IowaScaledEngineering/mrbw-cst/mech/pcb/front/img/faceplate-cu-1943.png

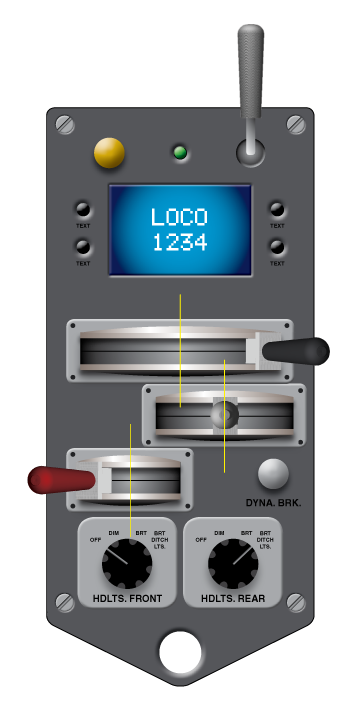
mech/pcb/front/img/faceplate-cu-1943.png
