IowaScaledEngineering/mrbw-cst/mech/pcb/front/img/lcd.jpg

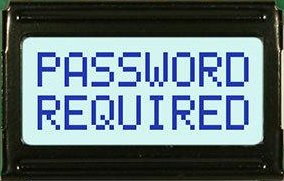
mech/pcb/front/img/lcd.jpg
