IowaScaledEngineering/mrbw-cst/mech/pcb/front/img/faceplate-1591d.png

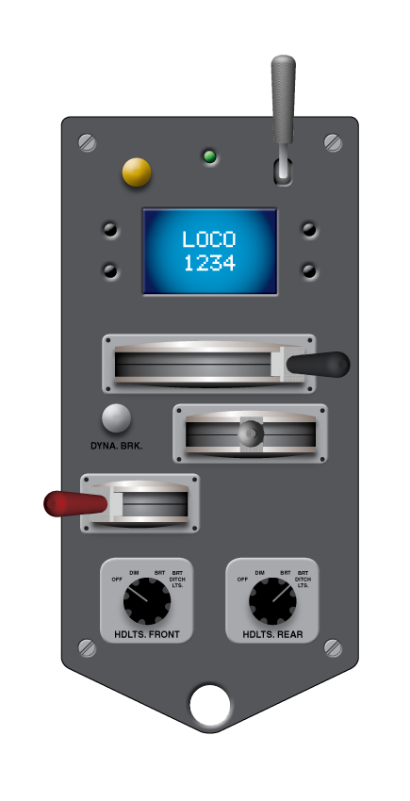
mech/pcb/front/img/faceplate-1591d.png
