IowaScaledEngineering/mrbw-cst/doc/calculations.ods

R1 | 0 | k
R2 | 200 | k
R3 | 100 | k
R4 | 49.9 | k
R5 | 0 | k to GND
VDD | 3.3 | V
 |  |  | Ideal
RA (R1/R2) | 3.300 | V | 3.3 | V
RB (R3/R2) | 2.200 | V | 2.2 | V
RC (R3/R4) | 1.099 | V | 1.1 | V
RD (R5/R4) | 0.000 | V | 0 | V
R1 | 10 | k
R2 | 69.8 | k
R3 | 42.2 | k
R4 | 25.5 | k
R5 | 178 | k
VDD | 3.3 | V
 |  |  | Ideal
RA (R1/R2) | 2.886 | V | 2.8875 | V
RB (R3/R2) | 2.057 | V | 2.0625 | V
RC (R3/R4) | 1.243 | V | 1.2375 | V
RD (R5/R4) | 0.414 | V | 0.4125 | V
