IowaScaledEngineering/mrbw-cst/doc/datasheets/NHD-0208AZ.STEP

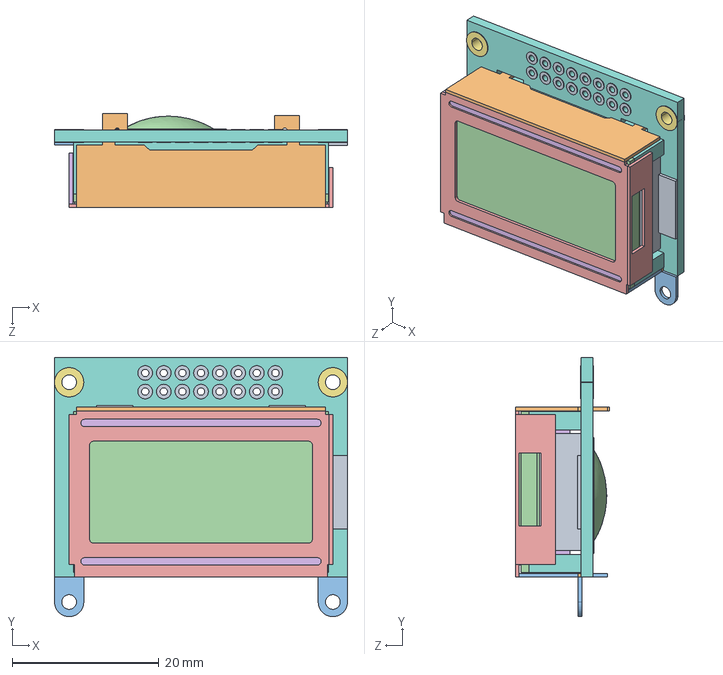
[picture p4: CAD file, 2018-02-15]
doc/datasheets/NHD-0208AZ.STEP
40.0 x 35.4 x 12.9 mm
