IowaScaledEngineering/mrbw-cst/mech/encoder-bracket/encoder-bracket-thread.stl

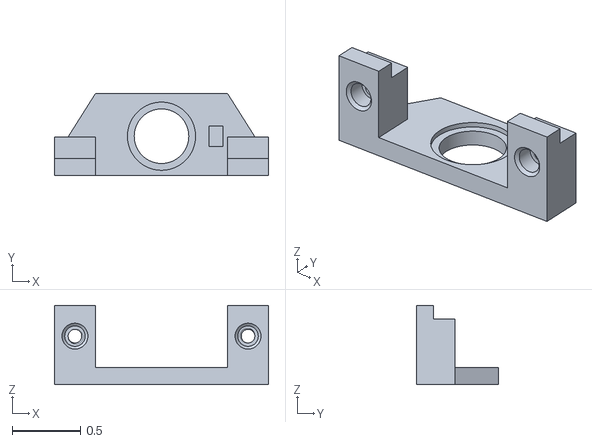
[picture p5: CAD file, 2020-06-07]
mech/encoder-bracket/encoder-bracket-thread.stl
1.57 x 0.6 x 0.58
