IowaScaledEngineering/mrbw-cst/mech/knob-holder/knob-holder v8.stl

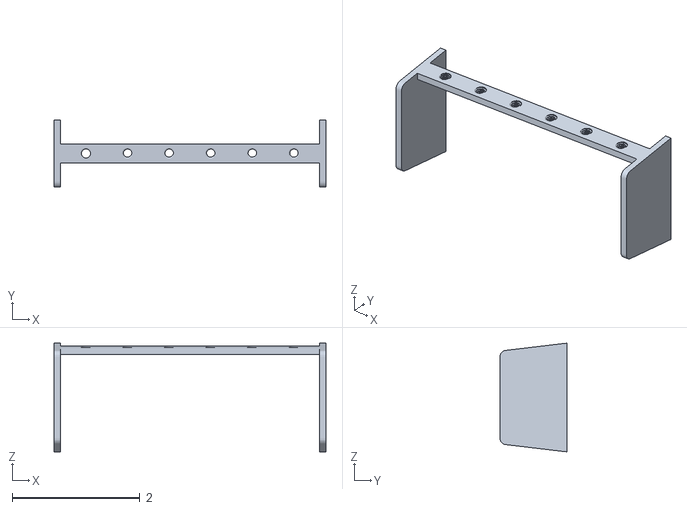
[picture p6: CAD file, 2024-02-22]
mech/knob-holder/knob-holder v8.stl
4.25 x 1.05 x 1.70
