IowaScaledEngineering/mrbw-cst/mech/pt-pocket/pt-pocket.stl

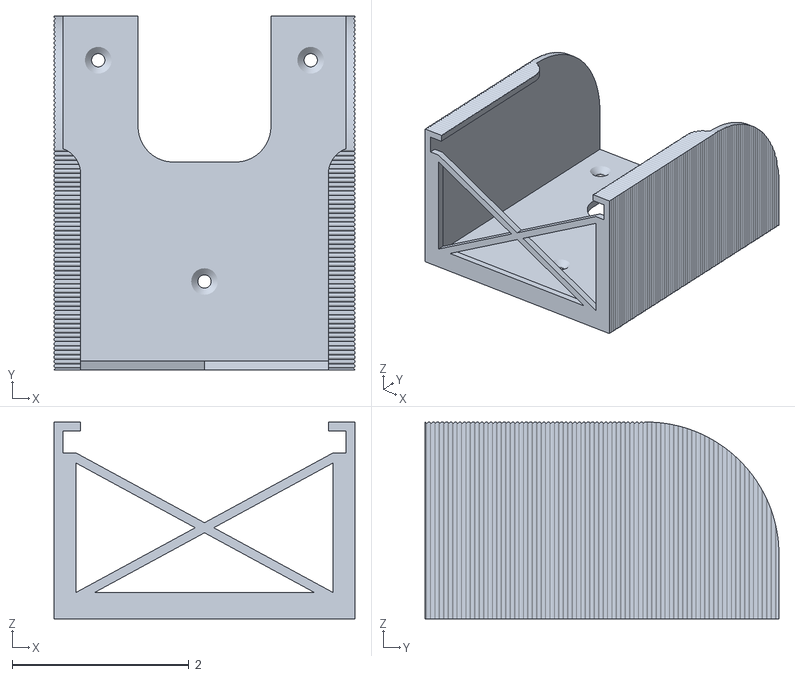
[picture p7: CAD file, 2019-04-13]
mech/pt-pocket/pt-pocket.stl
3.40 x 4.00 x 2.23
