IowaScaledEngineering/mrbw-cst/mech/window/window.dxf

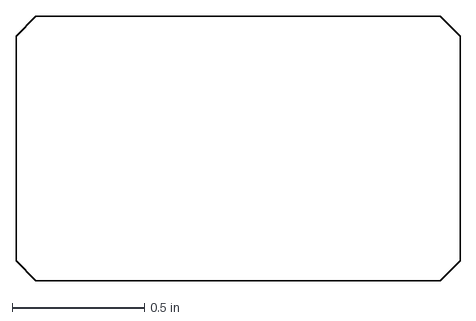
[picture p8: CAD file, 2020-03-28]
mech/window/window.dxf
1.68 x 1.00 in
