IowaScaledEngineering/mrbw-cst/mech/encoder-bracket/encoder-bracket.stl

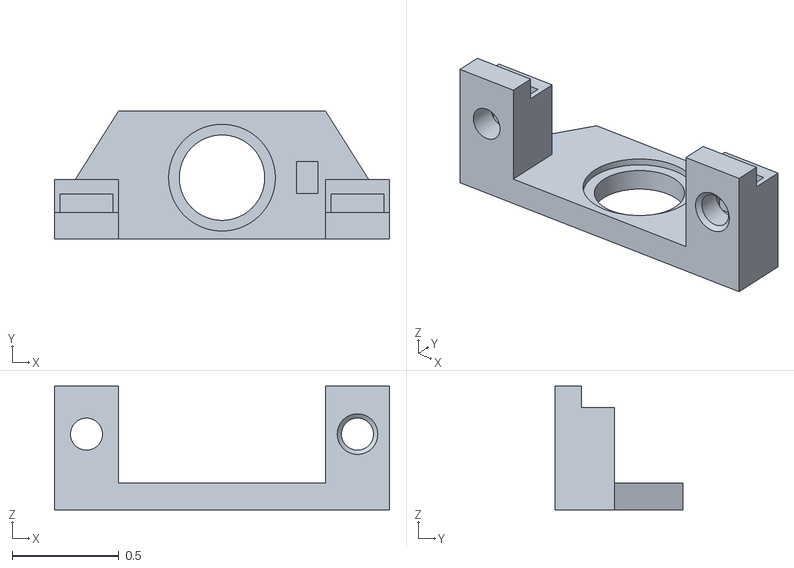
[picture p9: CAD file, 2019-06-08]
mech/encoder-bracket/encoder-bracket.stl
1.57 x 0.6 x 0.58
