IowaScaledEngineering/mrbw-cst/(list of files, cad)

Other CAD files:
mech/pcb/front/front.dwg
mech/pcb/front/parts/mrbw-cst.dwg
mech/pcb/side/side.dwg
mech/pcb/front/parts/PVA1.dwg
mech/pcb/side/parts/PPTC032LJBN-RC.dwg
mech/pcb/front/parts/mrbw-cst-lcd.dwg
mech/pcb/side/parts/2-1825910-(6-9).dwg
mech/pcb/front/parts/PTV09A-2020F-B104.dwg
mech/pcb/side/parts/3-1825910-(1-3).dwg
mech/pcb/front/parts/PPTC032LJBN-RC.dwg
mech/pcb/side/parts/NHD-0208AZ-FSW-GBW-33V3.dwg
mech/pcb/front/parts/CU-1943.dwg
mech/pcb/side/parts/PVA1-OA-H4.dwg
mech/pcb/front/parts/Hammond-1591D.dwg
mech/pcb/side/parts/PVA1-EE-H2.dwg
mech/pcb/front/parts/Rxxx07RN02Q.dwg
mech/pcb/side/parts/PVA1-OA-H2.dwg
mech/pcb/front/parts/25LB10-Q.dwg
mech/pcb/side/parts/Rxxx07RN02Q.dwg
mech/pcb/side/parts/PVA1-OA-H3.dwg
mech/pcb/side/parts/25LB10-Q(side).dwg
mech/pcb/side/parts/100SP2T1B1M1QEH.dwg
mech/pcb/side/parts/PTV09A-2020F-B104.dwg
mech/encoder-bracket/encoder-bracket-thread.f3d
mech/encoder-bracket/encoder-bracket.dwg
mech/encoder-bracket/encoder-bracket.f3d
mech/pcb/side/parts/6094K850_INDICATING_KNOB.DWG
