IowaScaledEngineering/mrbw-cst/pg/lcd-test-v1.0-a69d3a3/lcd-test-pcb.pdf

# lcd-test.pcb

# 1. Table of Contents (This Page) Created on Thu Jul 2 14:53:42 2020

# 2. top 3. bottom 4. outline 5. plated-drill 6. componentmask 7. soldermask 8. topsilk 9. bottomsilk 10. toppaste 11. topassembly 12. bottomassembly 13. fab

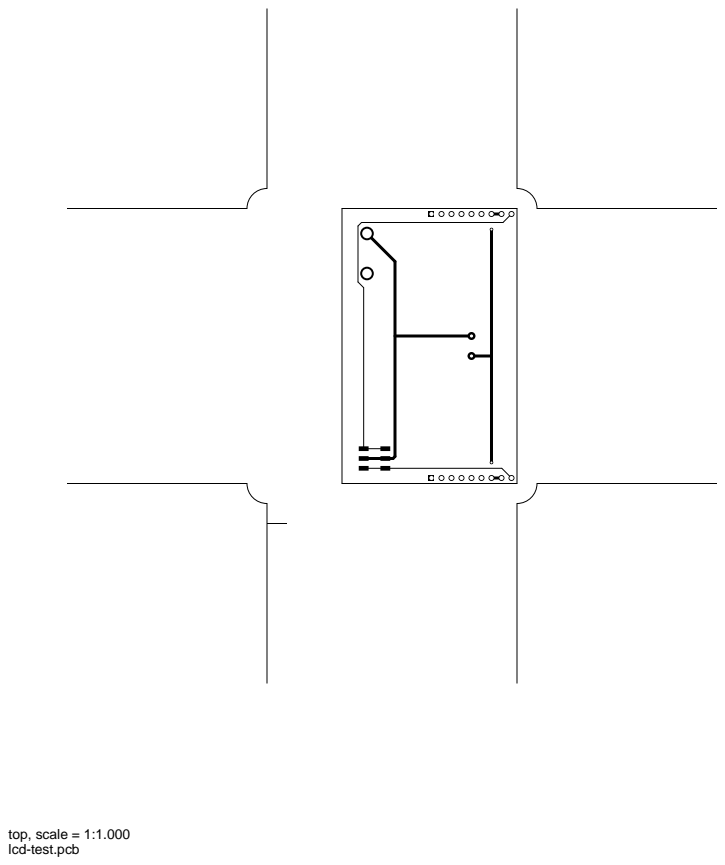
[picture p75: page 2]
top, scale = 1:1.000

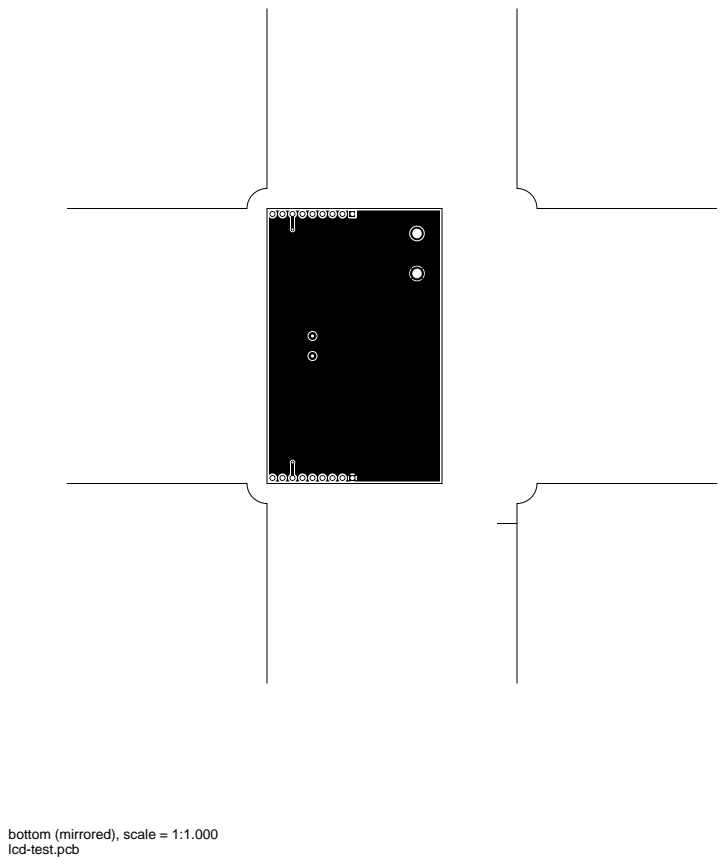
[picture p76: page 3]

bottom (mirrored), scale = 1:1.000

outline, scale = 1:1.000 plated-drill, scale = 1:1.000

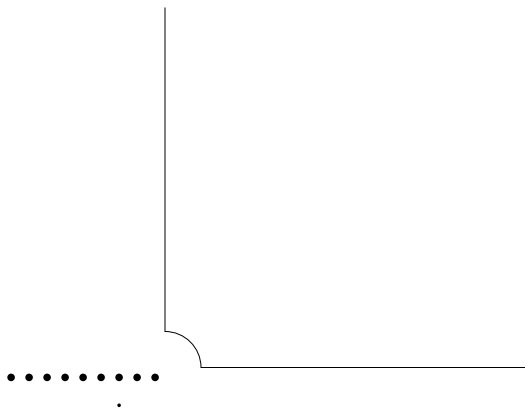
[picture p77: figure]
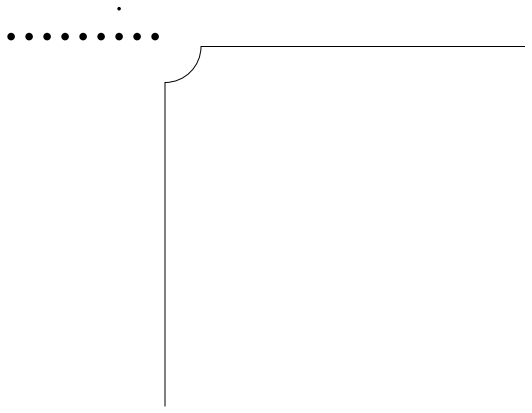
[picture p78: figure]

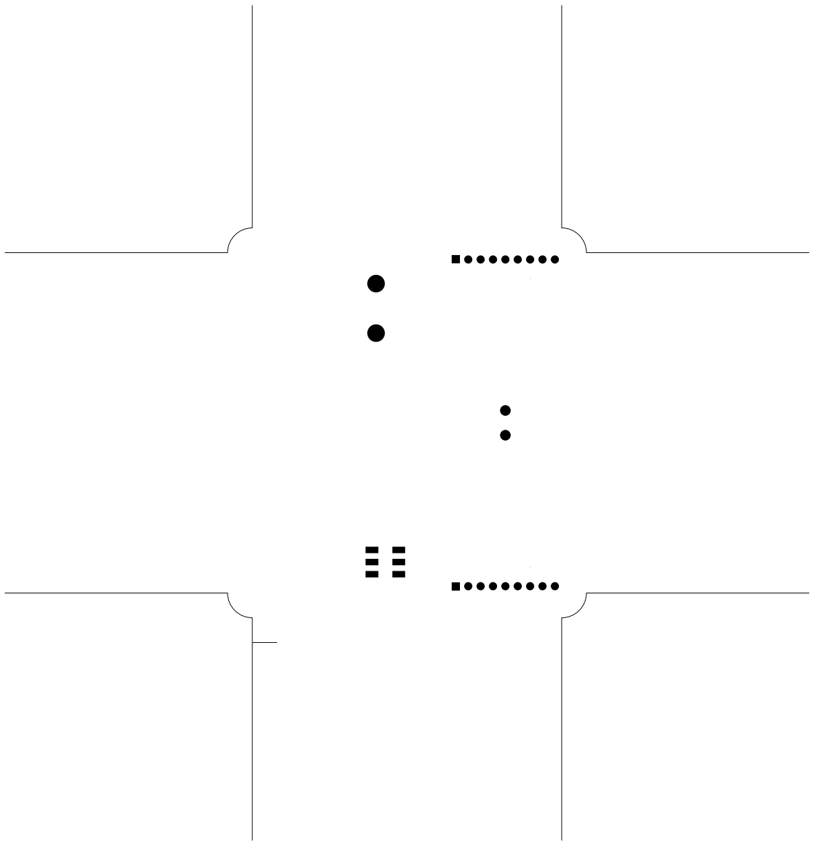
[picture p79: figure]

topmask, scale = 1:1.000

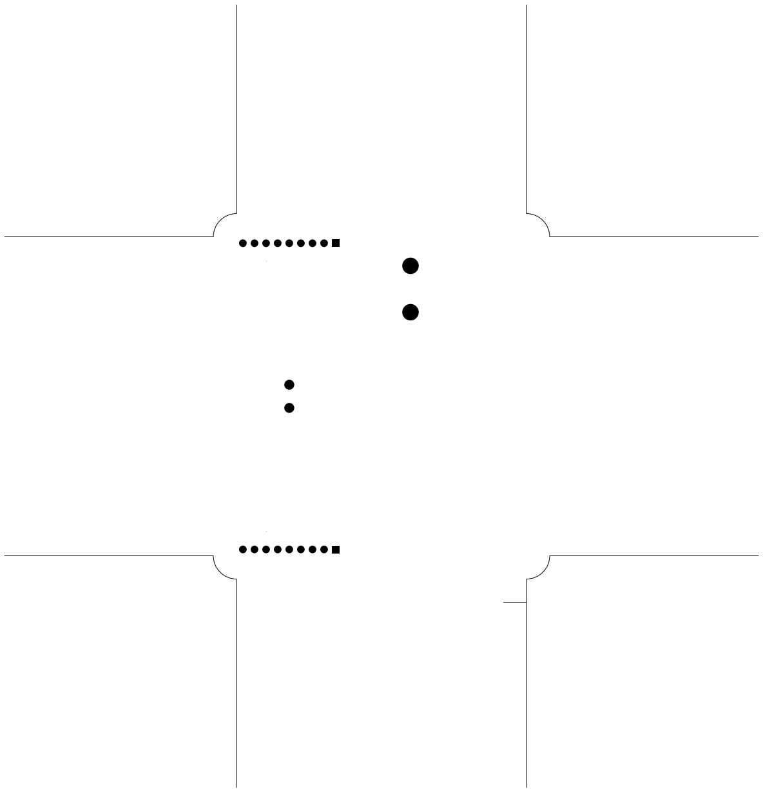
[picture p80: figure]

bottommask (mirrored), scale = 1:1.000

topsilk, scale = 1:1.000

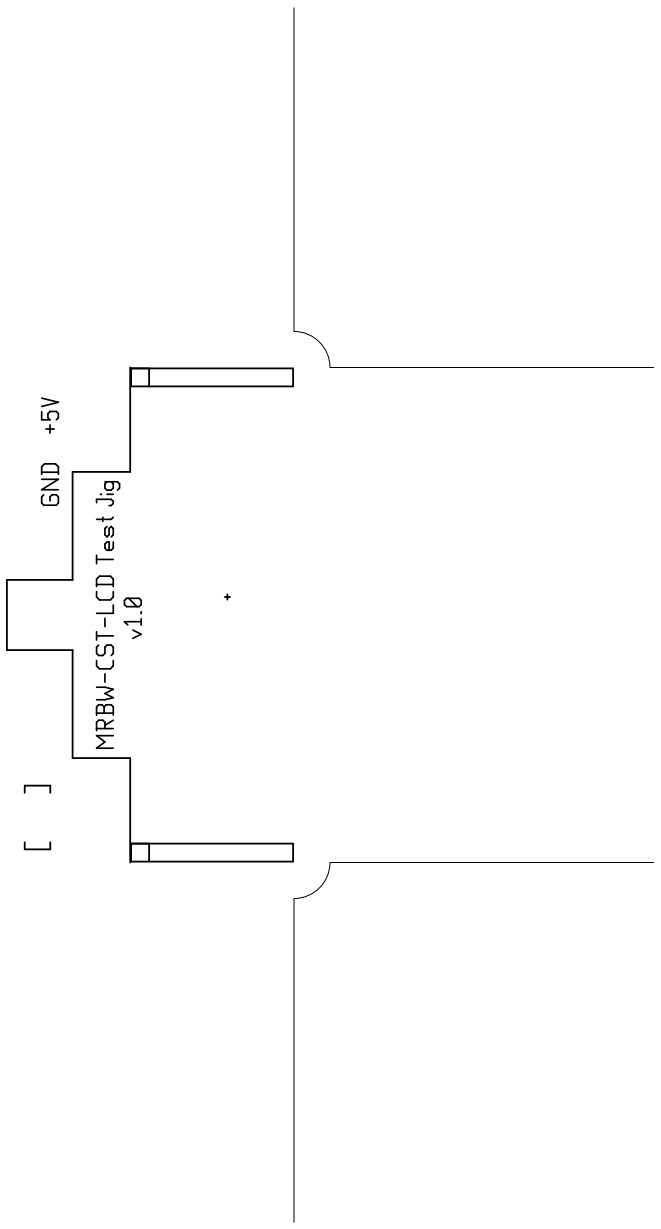
[picture p81: figure]

bottomsilk (mirrored), scale = 1:1.000

toppaste, scale = 1:1.000

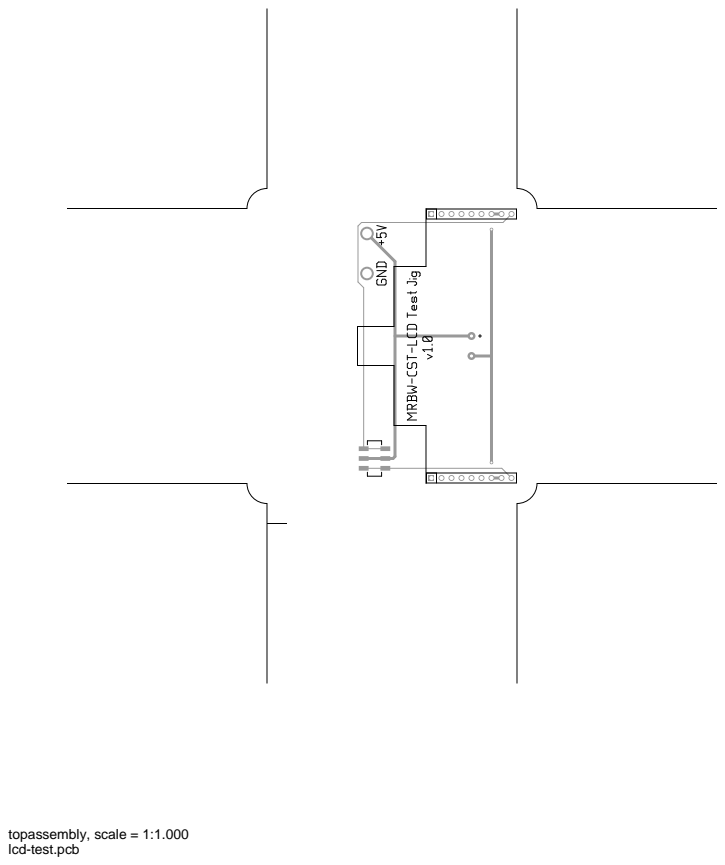
[picture p82: page 11]
topassembly, scale = 1:1.000

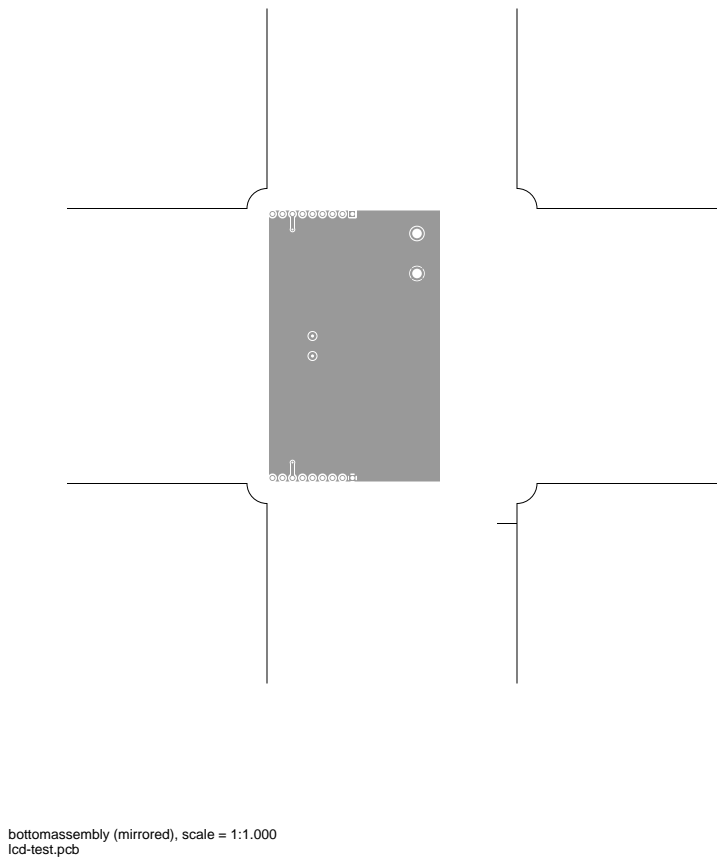
[picture p83: page 12]

bottomassembly (mirrored), scale = 1:1.000

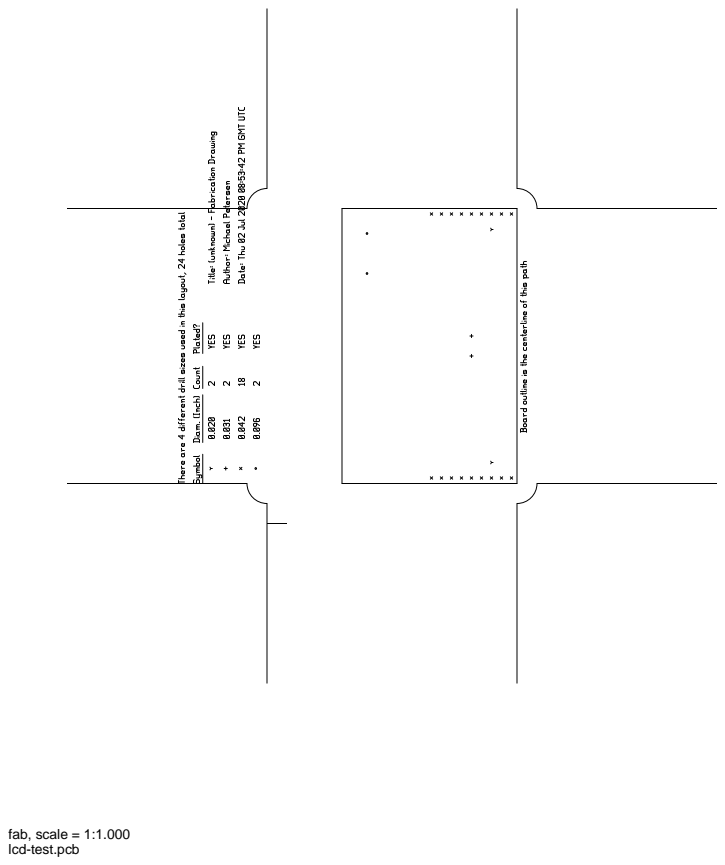
[picture p84: page 13]
fab, scale = 1:1.000
