IowaScaledEngineering/mrbw-cst/(threads)

Thread 1 (2016-07-19):

Missing pin 1 mark on MP1

petersenm, 2016-07-19:

petersenm, 2016-09-14:
Fix in 935ed32

Closed 2016-09-14.

Thread 3 (2016-07-19):

Use unused r-pack resistor for R3?

petersenm, 2016-07-19:

petersenm, 2016-09-14:
Not fixing.  No convenient path to R7 or R10.

Closed 2016-09-14.

Thread 4 (2016-07-19):

Use unused r-pack resistor for R5?

petersenm, 2016-07-19:
Also change C7 to 0.1uF.

petersenm, 2016-09-14:
Not changing.  There are no 10k r-packs and 100k is not typically used for /DTR based reset, which is planned for the future for Arduino compatibility.

Closed 2016-09-14.

Thread 6 (2016-10-09):

Reverse light switch connections so it defaults to "off" when breaking-before-making

petersenm, 2016-10-09:

petersenm, 2016-10-13:
Current operation, after refactoring the ADC code, seems to behave better.  Not sure why...

petersenm, 2017-01-16:
No design change.

Closed 2017-01-16.

Thread 7 (2016-10-10):

Connect backlight drive to PWM output pin to allow adjustment

petersenm, 2016-10-10:

petersenm, 2016-10-11:
Not changing.  Defaulted the screen to off in the main screen and provided an option to toggle the backlight on/off.

Closed 2016-10-11.

Thread 8 (2016-10-11):

Swap front and rear light switches

petersenm, 2016-10-11:
Front should be on the right.

Closed 2017-01-15.

Thread 11 (2016-11-10):

Add charging port

petersenm, 2016-11-10:

petersenm, 2017-03-23:
Added in v1.1 but won't be populated.

Closed 2017-03-23.

Thread 12 (2016-11-10):

Add USB port

petersenm, 2016-11-10:

petersenm, 2017-01-18:
No change.  Decided to leave the 6-pin ISP header as the programming port.  Fitting the UART and USB jack would be difficult and not provide much additional benefit.

Closed 2017-01-18.

Thread 16 (2017-03-25):

Move horn potentiometer right to eliminate collision with LCD board

petersenm, 2017-03-25:

Closed 2017-07-23.

Thread 17 (2017-03-25):

Replace light selection rotary switches

petersenm, 2017-03-25:

petersenm, 2017-04-05:
Original switches have a large region of "break" before making the next contact.  This allows the sensed voltage to swing low or high, both of which are also valid states.  The connection can be broken just by slightly applying pressure to the knob.  Since the throttle requires both poles to generate the switch position voltage, a single pole disconnecting is problematic.

E-Switch KC14A10.001NPS looks very promising as a substitute.  This would also allow a single voltage divider to set the tap points with both switches selecting from that divider (simplified design).

Closed 2017-07-20.

Thread 25 (2017-06-28):

Move E-stop to a different control

petersenm, 2017-06-28:

petersenm, 2017-08-15:
Decided with Scott to allow the user the choice of putting E-stop on the brake handle (as it currently stands), on one of the pushbuttons, or leave it off entirely.  Fully configurable.

petersenm, 2017-09-22:
Changed decision.  Just added option to have e-stop on brake handle or not.  No moving it to other controls.  Fixed by b3dcac883783b317102caad887ab386dba354539 .

Closed 2017-09-22.

Thread 26 (2017-06-28):

Add feedback when the electronic interlock between the throttle and reverser is active

petersenm, 2017-06-28:

petersenm, 2017-09-22:
Fixed by commit cd0187b.

Closed 2017-09-22.

Thread 28 (2017-09-28):

Packet timeout counter should have a power-on reset value of 0

petersenm, 2017-09-28:
Green LED blinks momentarily on a power-on-reset.

Closed 2017-09-30.

Thread 29 (2017-09-28):

Menu button doesn't work after a factory reset

petersenm, 2017-09-28:

Closed 2017-09-30.

Thread 30 (2017-11-22):

Add optional brake off function

petersenm, 2017-11-22:
This function is sent when the brake handle is moved to the left position.

petersenm, 2018-02-10:
Fixed by e469eb57a0213f46b7f42979ef8ab9b42b324d93

Closed 2018-02-10.

Thread 38 (2018-01-07):

Add preference option to remove the interlock between reverser and throttle

petersenm, 2018-01-07:

Thread 49 (2018-04-13):

In variable braking mode, the Brake Off function should be activated opposite the Brake function

petersenm, 2018-04-13:

petersenm, 2018-04-22:
Fixed in cef6c46

Closed 2018-04-22.

Thread 53 (2018-04-20):

Manual updates

petersenm, 2018-04-20:
New load/save configuration menus
Number of configs = 20
Function for rev swap
Brake type option
Moved some global preferences to per-config options
Update page 5 list of supported systems

Closed 2018-06-15.

Thread 54 (2018-04-21):

Move variable brake to a per-configuration option setting

petersenm, 2018-04-21:

petersenm, 2018-05-12:
Fixed in fb8f584

Closed 2018-05-12.

Thread 55 (2018-04-21):

Add pulsed (PWM) vs. stepped braking option

petersenm, 2018-04-21:
Pulse is universal.  Stepped is targeted at TCS.

petersenm, 2018-05-12:
Fixed in 0866e74

Closed 2018-05-12.

Thread 60 (2018-07-11):

Make menu button long-press escape any menu, including sub-menus

petersenm, 2018-07-11:

petersenm, 2020-03-28:
Not a great idea.  Can escape some menus with changes still intact.  Forcing a SELECT button exit reinforces that changes were saved.

Closed 2020-03-29.

Thread 61 (2018-07-14):

Add a null address so the throttle can be put in a state where it doesn't send updates

petersenm, 2018-07-14:
...or conflict with another locomotive address being used by a different throttle.

Thread 62 (2018-07-14):

Add menu lock

petersenm, 2018-07-14:
Options:
1)  Prompted button press sequence
2)  Unprompted ("secret") button press sequence
3)  PIN #
4)  Full reboot (remove/reinsert batteries)

petersenm, 2018-07-14:
One response from the PT list:
"something to keep an operator from changing throttle settings, not something to prevent unauthorized entry"

petersenm, 2018-10-03:
Fixed in a08c1f4

Closed 2018-10-03.

Thread 63 (2018-07-23):

Fix low battery behavior

petersenm, 2018-07-23:
The throttle enters a hiccup mode when the battery gets critically low.  Possible solution is to go into a low power state when the battery voltage is low.

petersenm, 2018-07-23:
If possible, send an estop command when battery is low.

petersenm, 2018-07-25:
Or put the throttle in idle, engage the brake function, and sound the horn (suggestion from PT list)

petersenm, 2018-09-22:
Just put the throttle in a low power state.  Sending XBee packets is what causes the hiccup mode in the first place.  Stopping the train will be taken care of on the receiver side.

Closed 2018-09-22.

Thread 64 (2018-08-01):

Save current engine on/off state with each configuration

petersenm, 2018-08-01:

petersenm, 2018-08-01:
https://groups.io/g/ProtoThrottle/message/779

petersenm, 2018-09-22:
Should this track configurations?  The problem with that is the locomotive address of a config can be changed temporarily to address a different locomotive.  In that case, it should really track locomotive address.  But that has unrealistic memory requirements to track ALL possible addresses.  Perhaps just a FIFO of the last N addresses used?

Thread 65 (2018-08-12):

Add programmable battery low thresholds

petersenm, 2018-08-12:
This can be used to accommodate NiMH vs. Alkaline battery discharge curves.

petersenm, 2018-10-11:
Fixed in 179ac77

Closed 2018-10-11.

Thread 73 (2018-09-28):

Add indicator for AUX button on main screen

petersenm, 2018-09-28:

petersenm, 2018-10-03:
Resolved in 268238b

Closed 2018-10-03.

Thread 75 (2018-10-11):

Rework maxDeadReckoning preference so limiting (and default) is done in cst-time

petersenm, 2018-10-11:
See battery levels in SYSTEM menu, and resetConfig, for examples.

Closed 2020-03-28.

Thread 78 (2018-11-08):

Provide option to replace fast clock display with other information

petersenm, 2018-11-08:
https://groups.io/g/ProtoThrottle/message/1284

petersenm, 2020-03-29:
Idea #1: Brake percentage

petersenm, 2020-03-29:
Ideas:

petersenm, 2020-03-29:
Ideas:
1) Brake percentage
2) Speed (or some representation of it)

petersenm, 2022-02-20:
3. Notch #

Thread 79 (2019-01-24):

Select button on ENGINE menu activates power down mode

petersenm, 2019-01-24:
Although not intended, this might be a feature?  Best to understand why it happens, though.

petersenm, 2019-01-24:
Same for tonnage menu

Closed 2019-02-12.

Thread 81 (2019-11-13):

Add alerter function

petersenm, 2019-11-13:
From a customer request:
"I'm thinking of having it ring the bell (which will be on F1) after about 90 seconds of no throttle inputs. If still no input after another 30 seconds, then it should set throttle to idle and apply brakes. Times should be adjustable, of course. This will be used with Loksound V5 decoders, and brake will probably be on F6, but the function should be assignable. If for some reason it's too hard to have the throttle go to idle, overriding the throttle handle, then I'll be sure that "Drive Stop" is turned on in the decoder programming for the Independent Brake sound slot. That will also cause the loco to come to a stop."  (#6109)

petersenm, 2020-04-04:
Done in ab6d867

Closed 2020-04-04.

Thread 82 (2019-11-17):

Add button option to jump into special funcs menu.

petersenm, 2019-11-17:

petersenm, 2020-04-01:
Fixed in 8a039a0

Closed 2020-04-01.

Thread 87 (2020-05-10):

Add brake pipe pressure options

petersenm, 2020-05-10:
70PSI (very early, 20PSI reduction)
80PSI (1940's - 1970's, 23PSI reduction)
90PSI (1970's on, 26PSI reduction)
110PSI (Passenger, 32PSI reduction)

petersenm, 2020-05-10:
Also, brake lever position should correspond to a specific pipe reduction from maximum (not from current pressure).

Thread 89 (2020-09-25):

Use aux button to swap throttle lever from throttle function to dynamic brake function

petersenm, 2020-09-25:

Thread 94 (2021-04-18):

Unprogrammed throttle resets to the wrong DIAG screen

petersenm, 2021-04-18:
Subscreen number is off by one.

Thread 97 (2021-11-07):

Don't toggle backlight off when pressing select button until button is released

petersenm, 2021-11-07:
This will leave backlight on while long pressing for shutdown.  Backlight should remain on during long press regardless of initial backlight state.

(From email to support@iascaled.com 2021-05-23 13:07, RE: Broken Throttle Lever)
