IowaScaledEngineering/mrbw-cst/pg/mrbw-cst-v1.2-ddb21f6/mrbw-cst.pdf

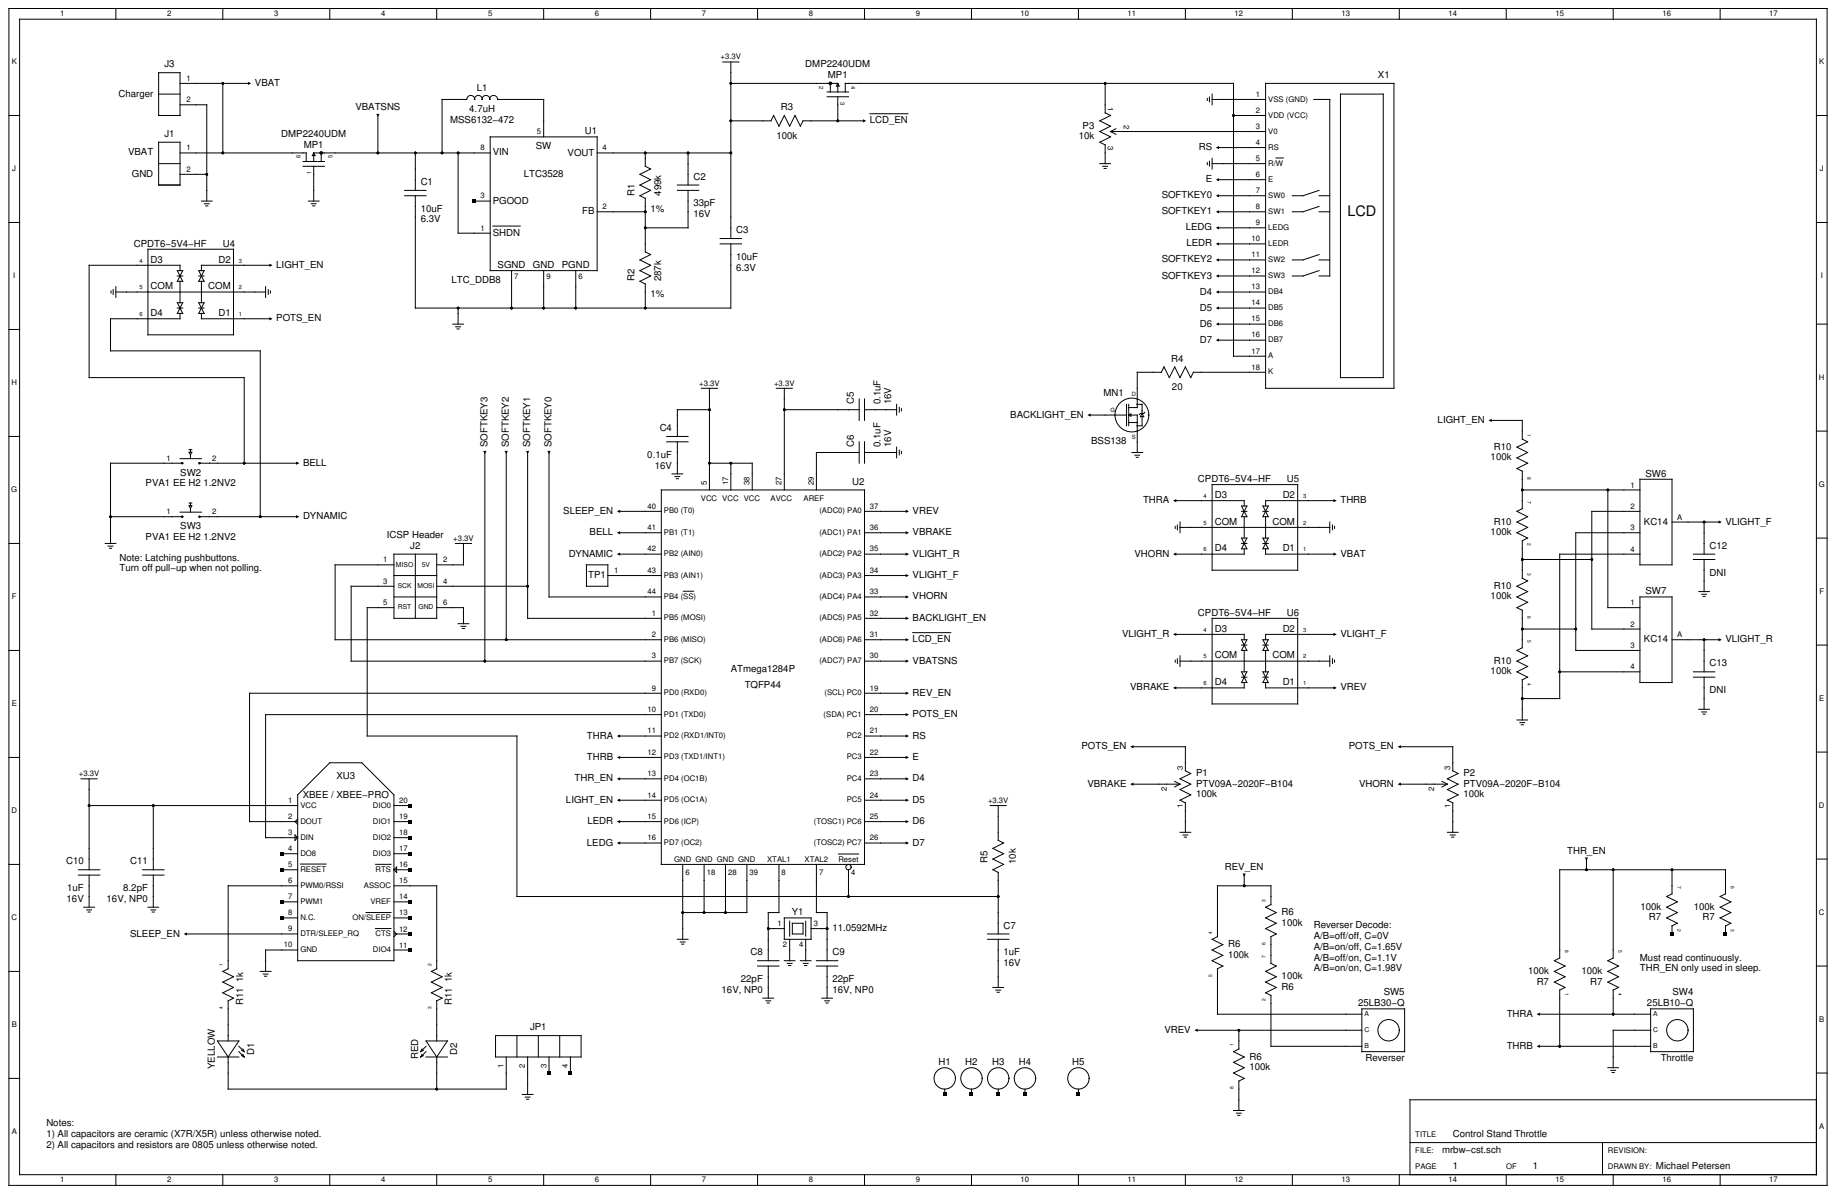
[picture p85: page 1]

Note: Latching pushbuttons.
Turn off pull−up when not polling.

Must read continuously.
THR_EN only used in sleep.

Notes:
1) All capacitors are ceramic (X7R/X5R) unless otherwise noted.
2) All capacitors and resistors are 0805 unless otherwise noted.
