IowaScaledEngineering/mrbw-cst/pg/mrbw-cst-v1.2-ddb21f6/mrbw-cst-pcb.pdf

# mrbw-cst.pcb

# 1. Table of Contents (This Page) Created on Mon Aug 21 20:05:26 2017

# 2. top 3. bottom 4. outline 5. plated-drill 6. componentmask 7. soldermask 8. topsilk 9. bottomsilk 10. toppaste 11. topassembly 12. bottomassembly 13. fab

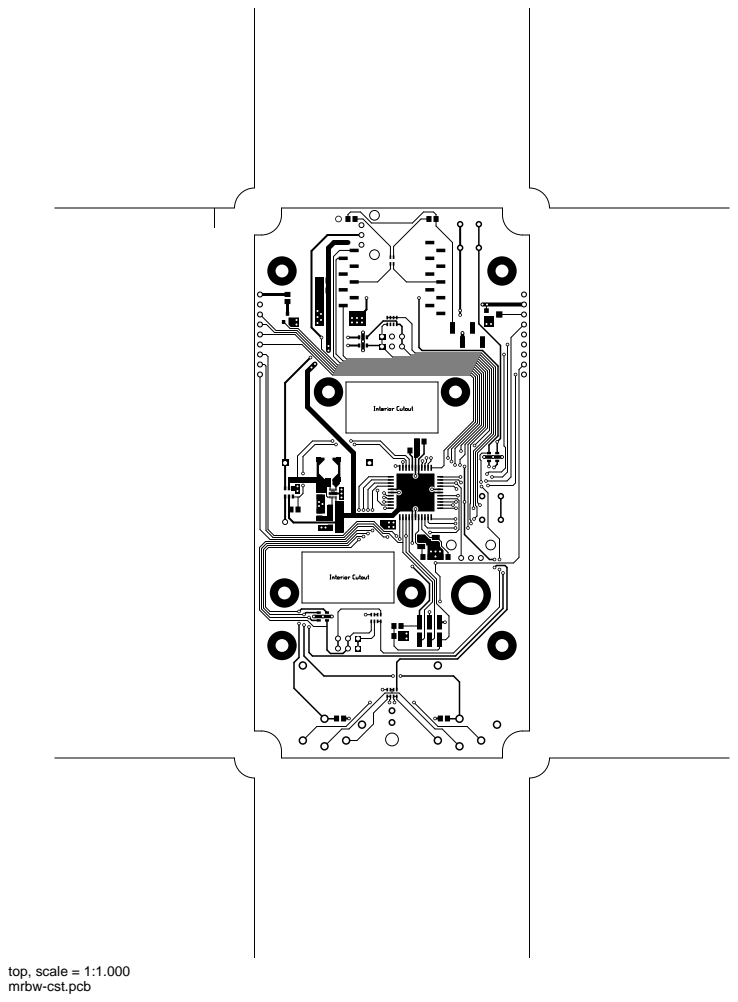
[picture p86: page 2]
top, scale = 1:1.000

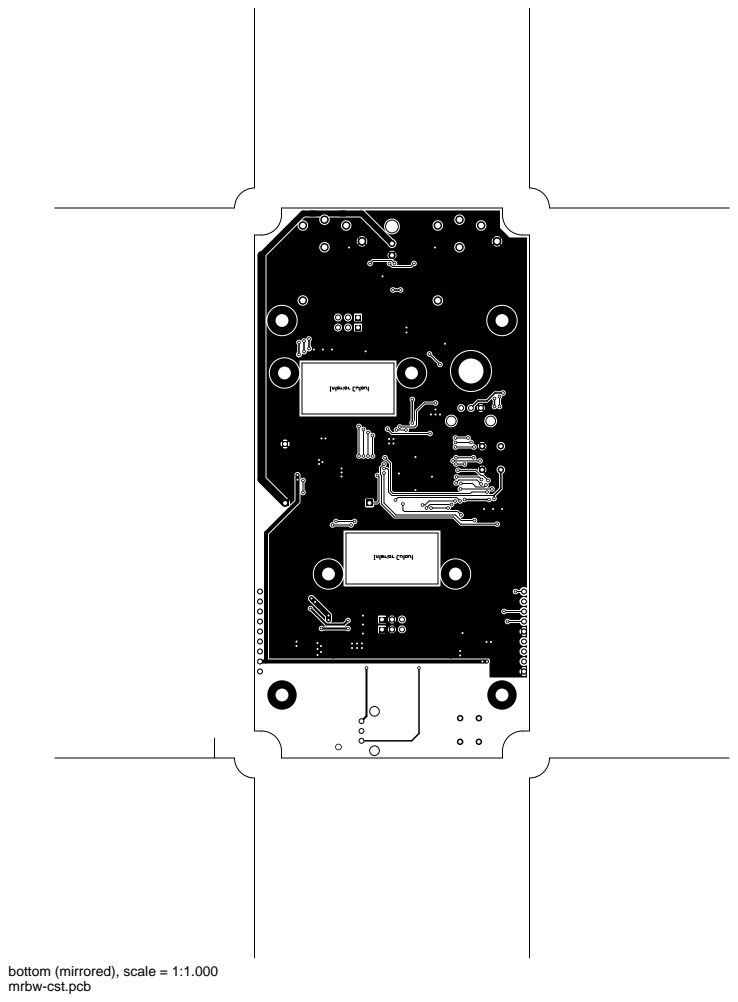
[picture p87: page 3]

bottom (mirrored), scale = 1:1.000

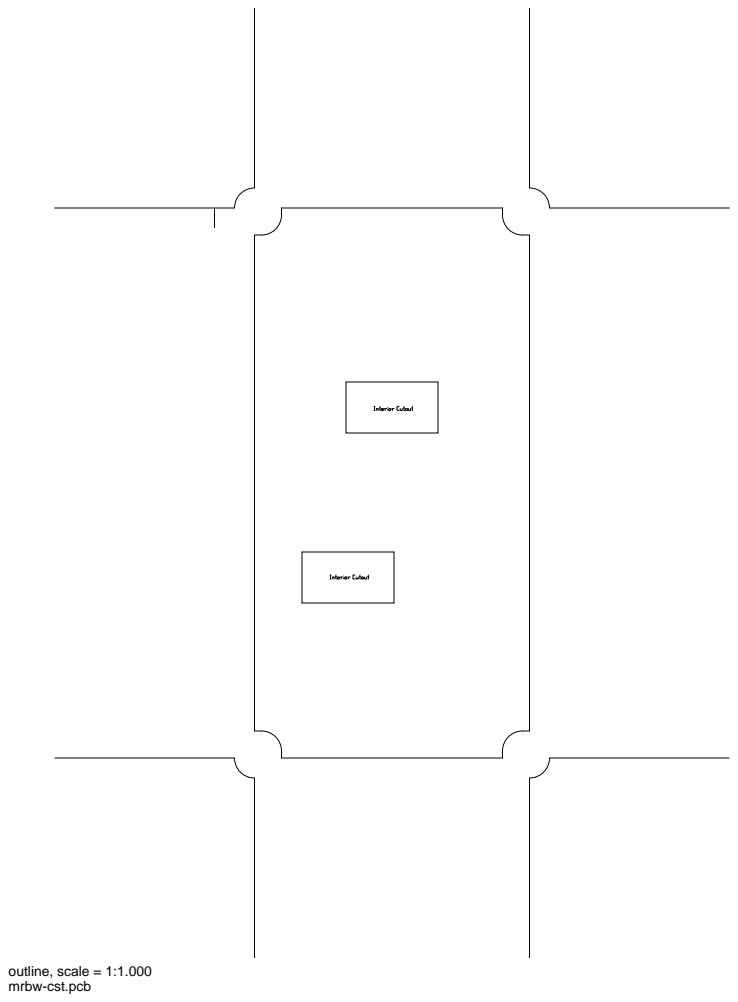
[picture p88: page 4]
outline, scale = 1:1.000

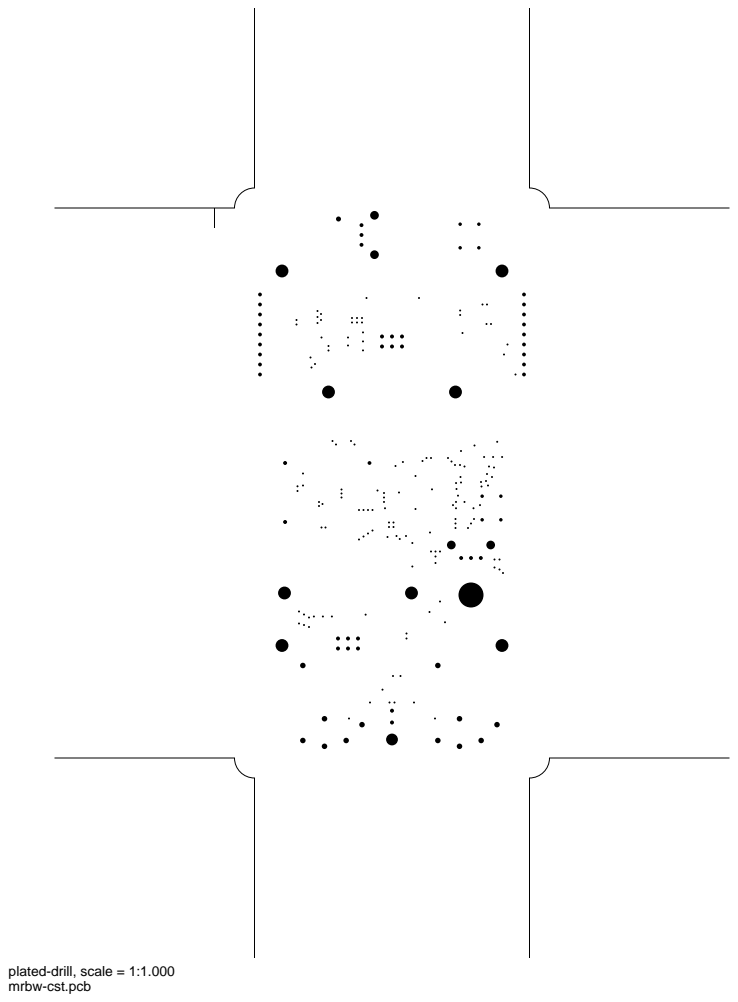
[picture p89: page 5]

plated-drill, scale = 1:1.000

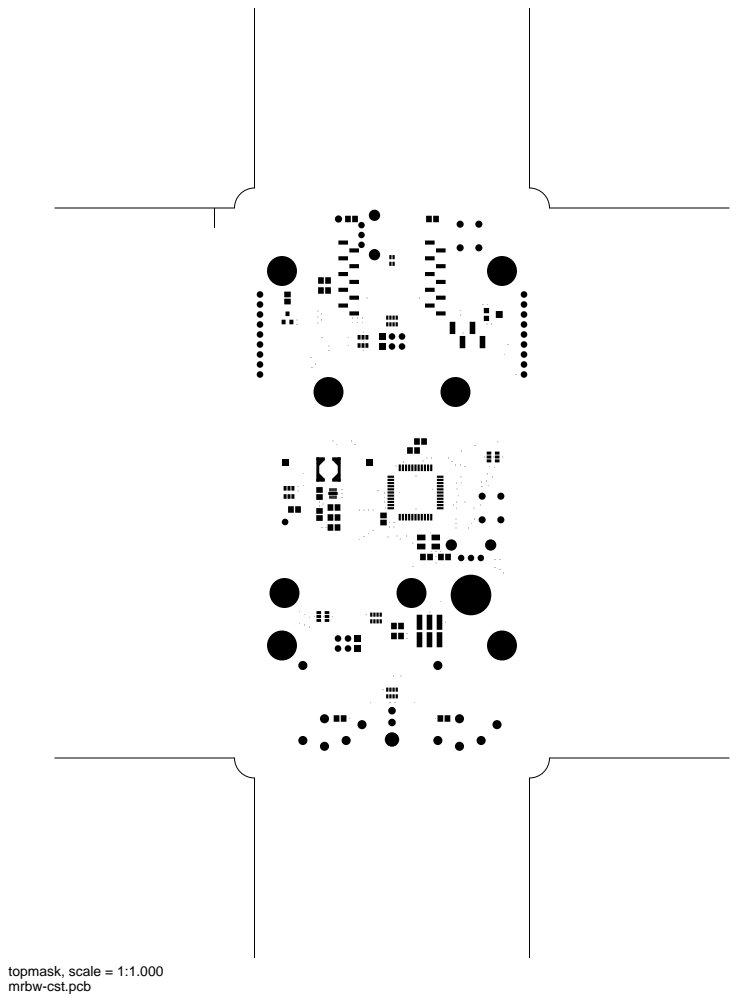
[picture p90: page 6]
topmask, scale = 1:1.000

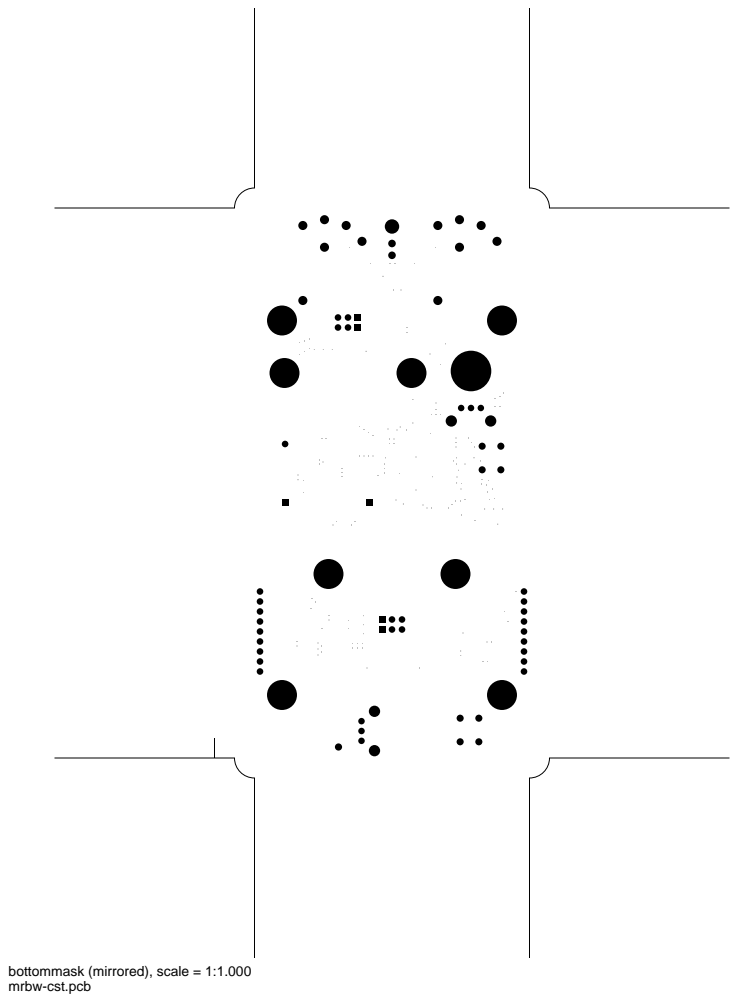
[picture p91: page 7]

bottommask (mirrored), scale = 1:1.000

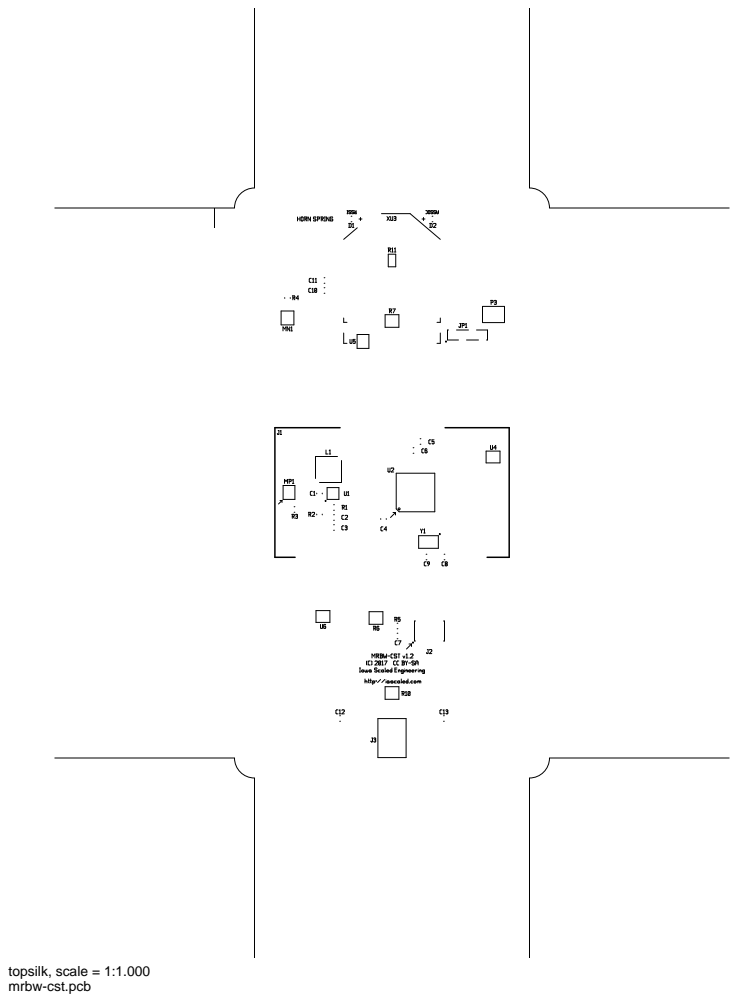
[picture p92: page 8]
topsilk, scale = 1:1.000

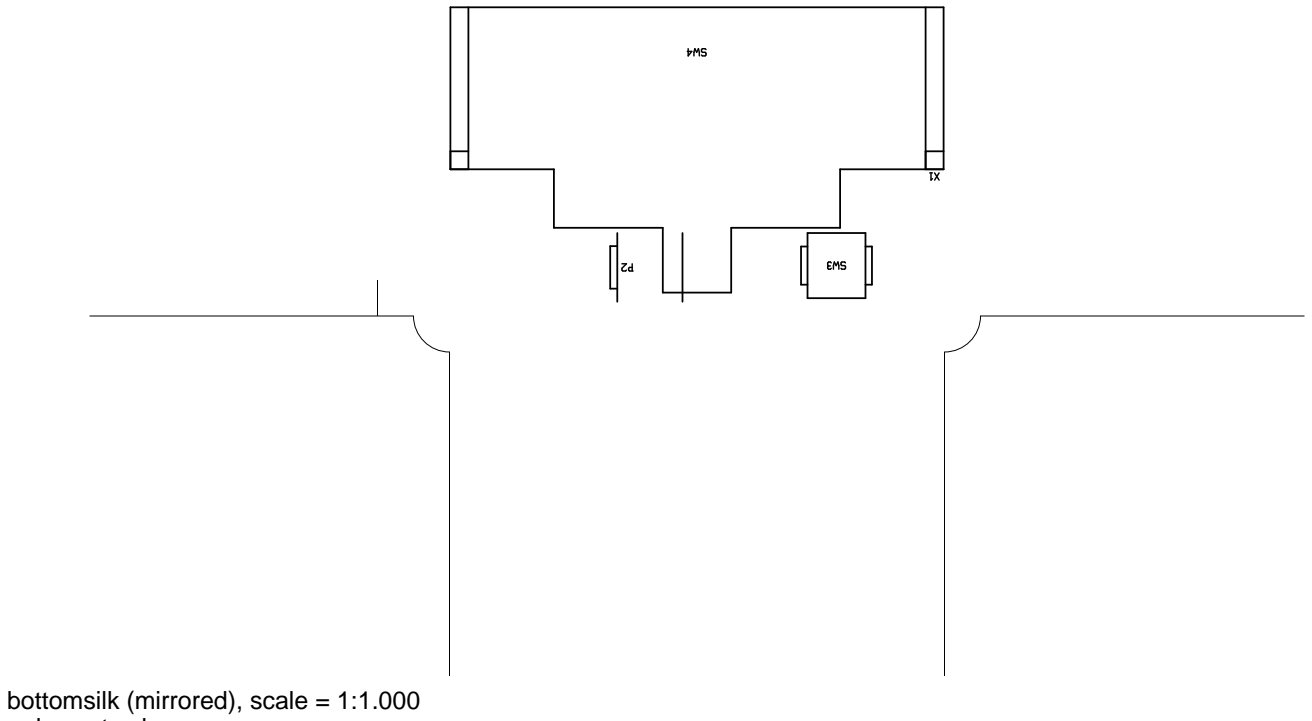
[picture p93: figure]
bottomsilk (mirrored), scale = 1:1.000

toppaste, scale = 1:1.000

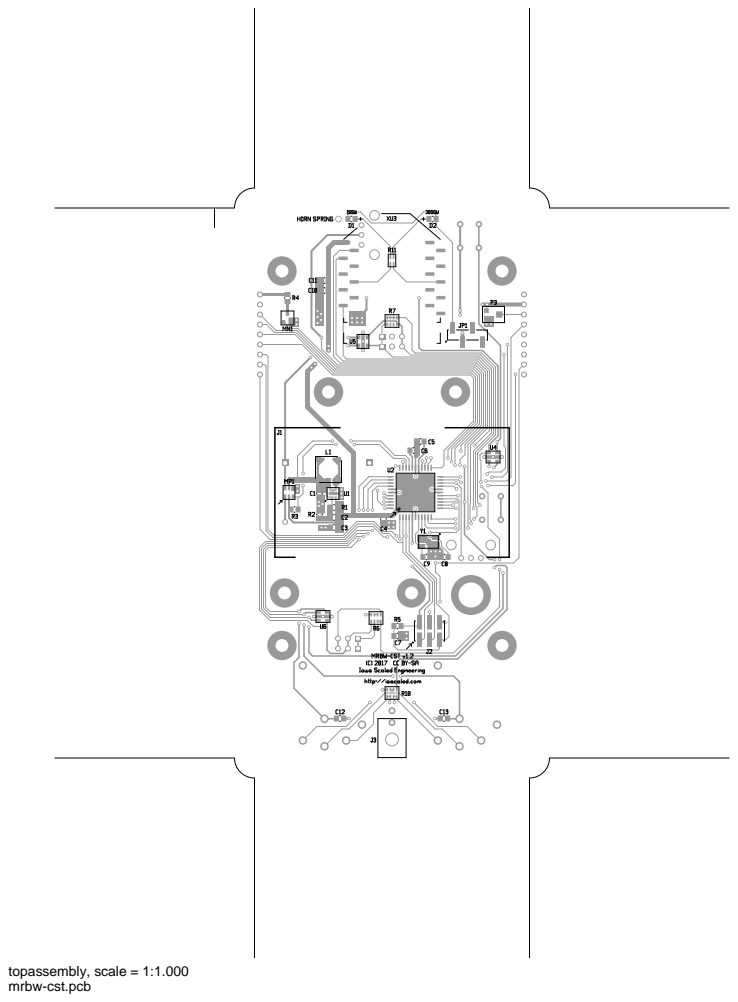
[picture p94: page 11]
topassembly, scale = 1:1.000

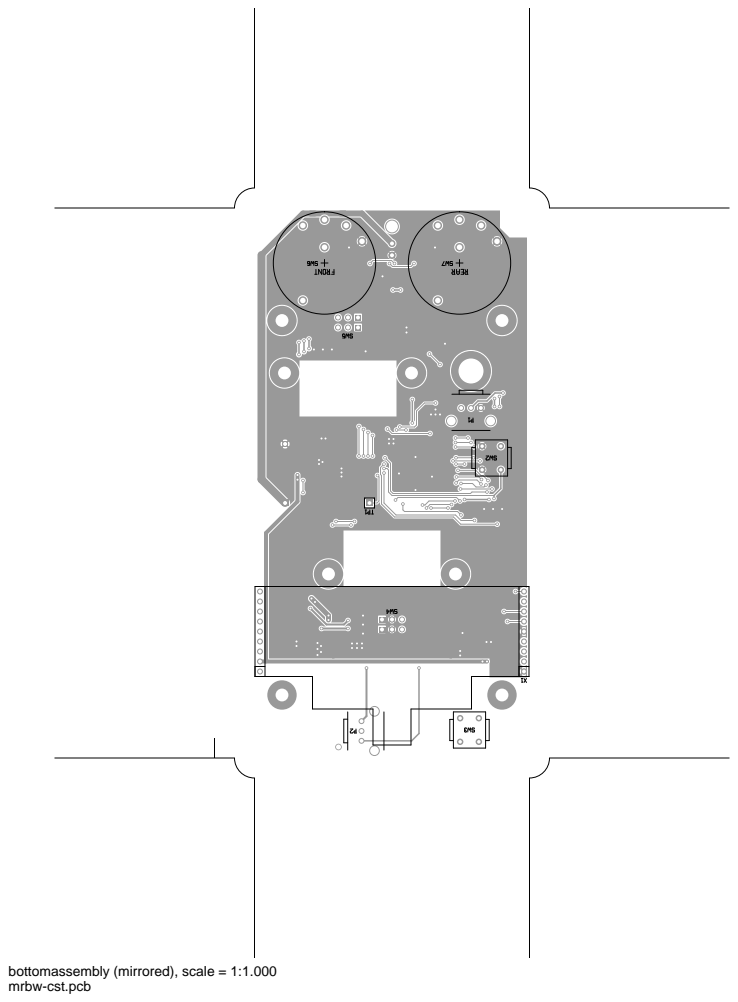
[picture p95: page 12]

bottomassembly (mirrored), scale = 1:1.000

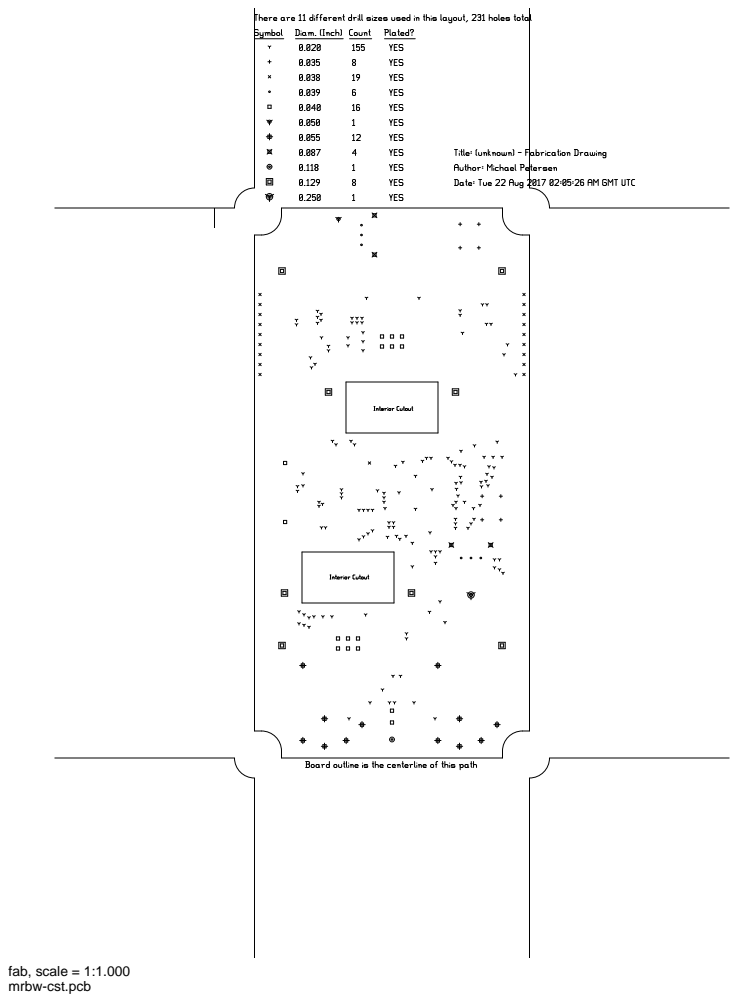
[picture p96: page 13]
fab, scale = 1:1.000
