IowaScaledEngineering/mrbw-cst/pg/mrbw-cst-lcd-v1.0-705284b/mrbw-cst-lcd-pcb.pdf

# mrbw-cst-lcd.pcb

# 1. Table of Contents (This Page) Created on Mon Jun 27 21:12:46 2016

# 2. top 3. bottom 4. outline 5. plated-drill 6. unplated-drill 7. componentmask 8. soldermask 9. topsilk 10. bottomsilk 11. toppaste 12. topassembly 13. bottomassembly 14. fab

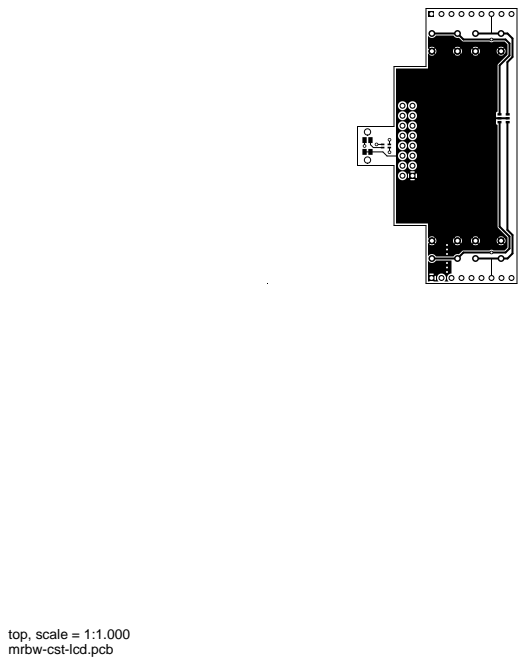
[picture p97: page 2]
top, scale = 1:1.000

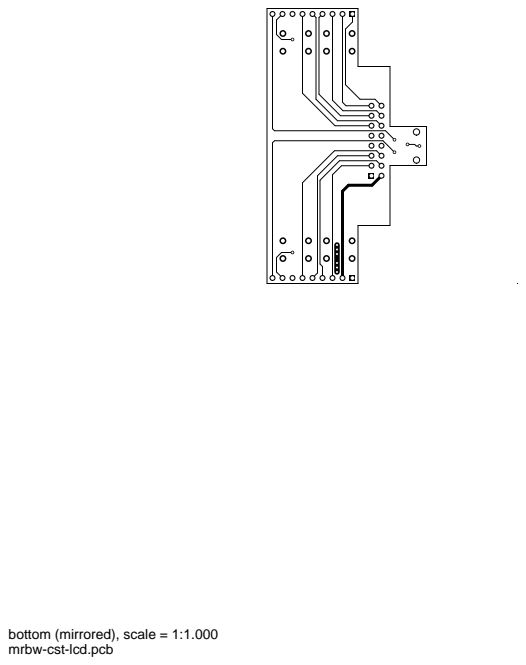
[picture p98: page 3]

bottom (mirrored), scale = 1:1.000

outline, scale = 1:1.000

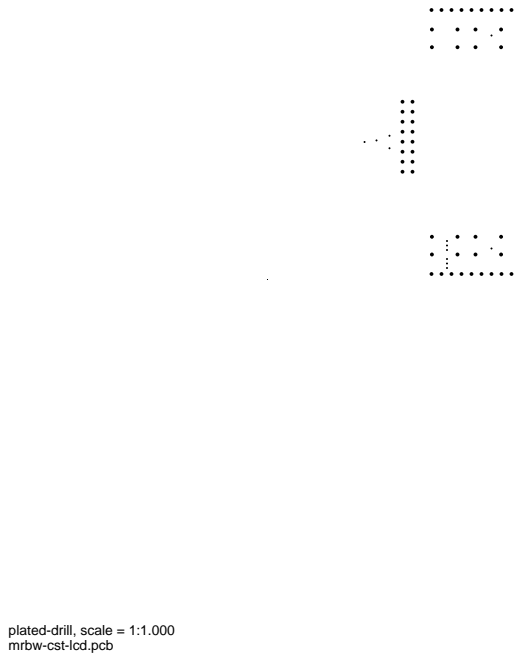
[picture p99: page 5]

plated-drill, scale = 1:1.000

unplated-drill, scale = 1:1.000

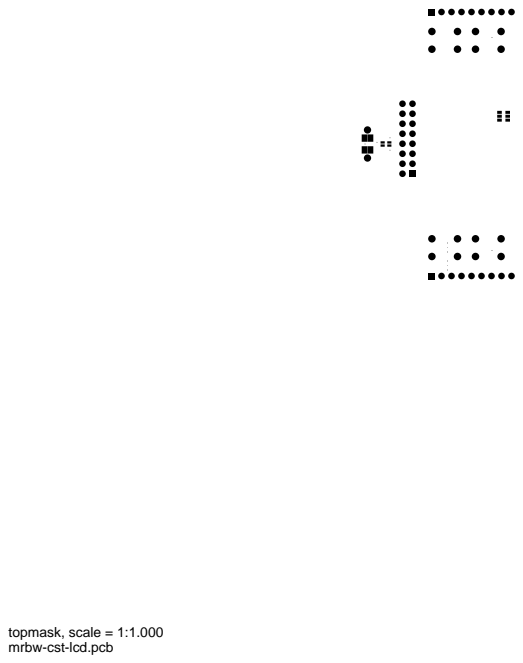
[picture p100: page 7]
topmask, scale = 1:1.000

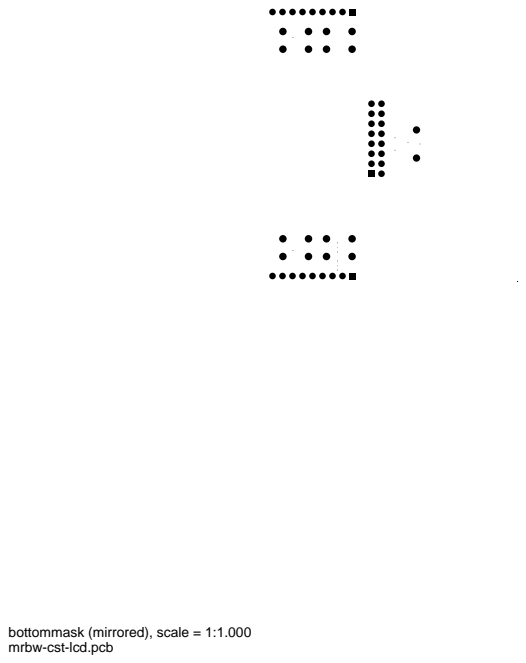
[picture p101: page 8]

bottommask (mirrored), scale = 1:1.000

topsilk, scale = 1:1.000

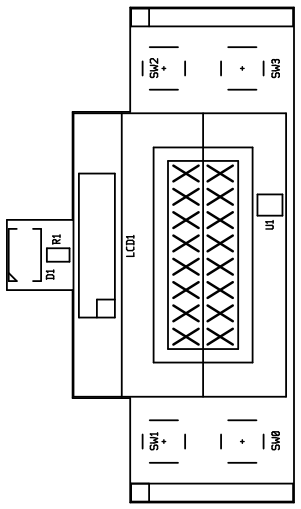
[picture p102: figure]

bottomsilk (mirrored), scale = 1:1.000

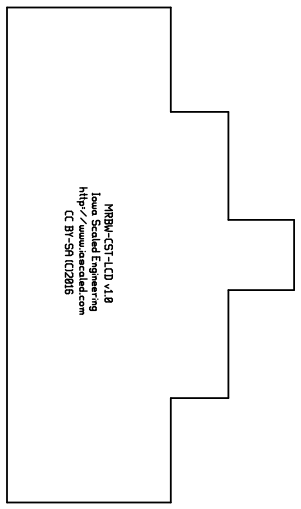
[picture p103: figure]

toppaste, scale = 1:1.000

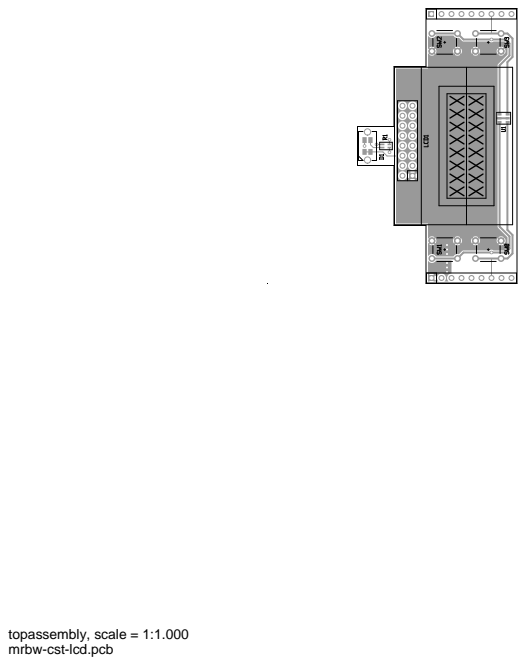
[picture p104: page 12]
topassembly, scale = 1:1.000

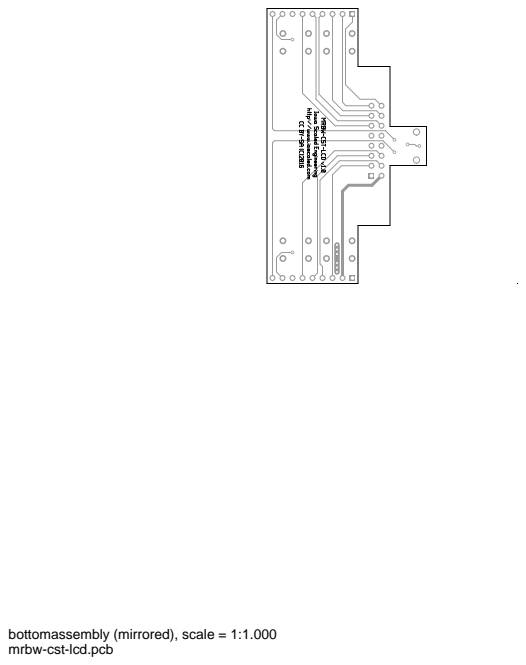
[picture p105: page 13]

bottomassembly (mirrored), scale = 1:1.000

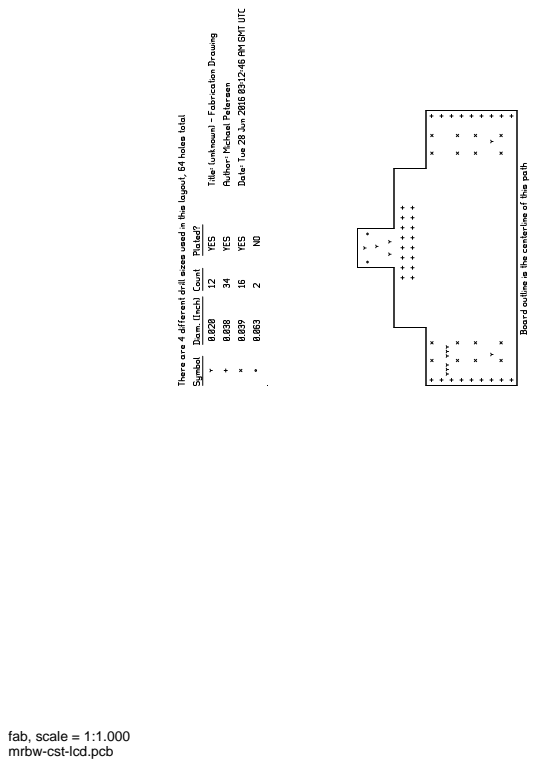
[picture p106: page 14]
fab, scale = 1:1.000
