IowaScaledEngineering/mrbw-cst/pg/mrbw-cst-lcd-v1.0-705284b/mrbw-cst-lcd.pdf

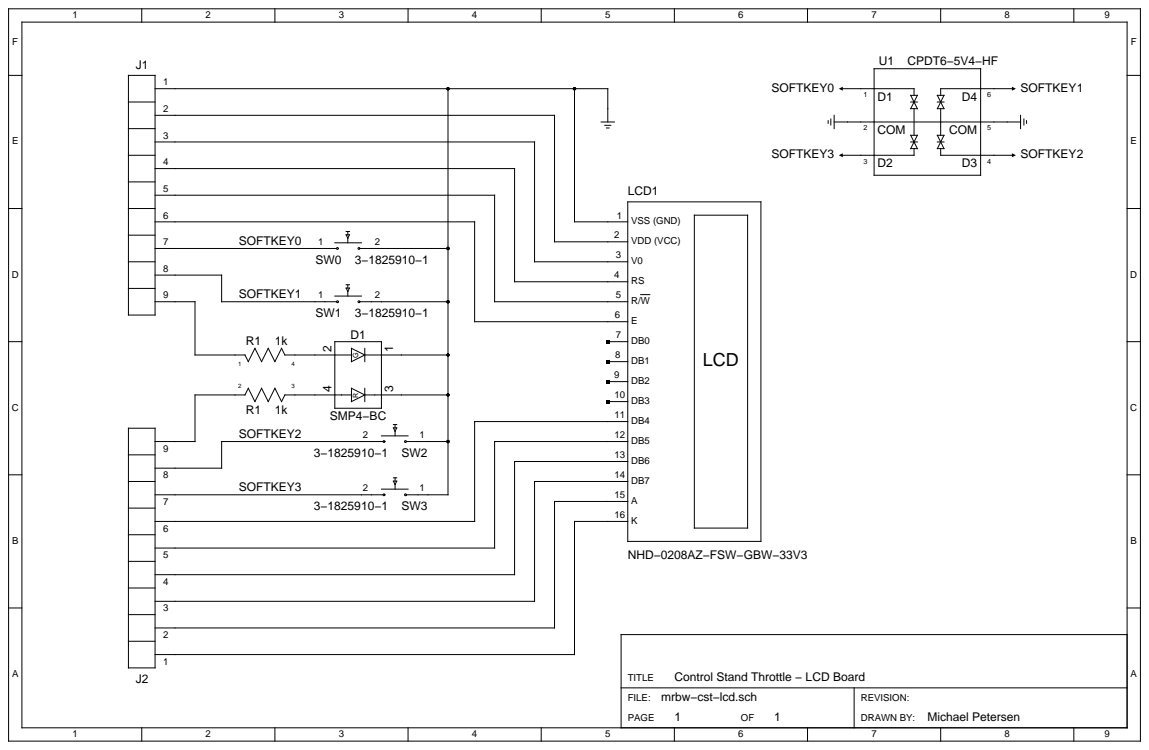
[picture p107: page 1]

Control Stand Throttle − LCD Board
mrbw−cst−lcd.sch
