IowaScaledEngineering/mrbw-cst/doc/usermanual/mrbw-cst-menu-v1.2.pdf

# MENU MAP

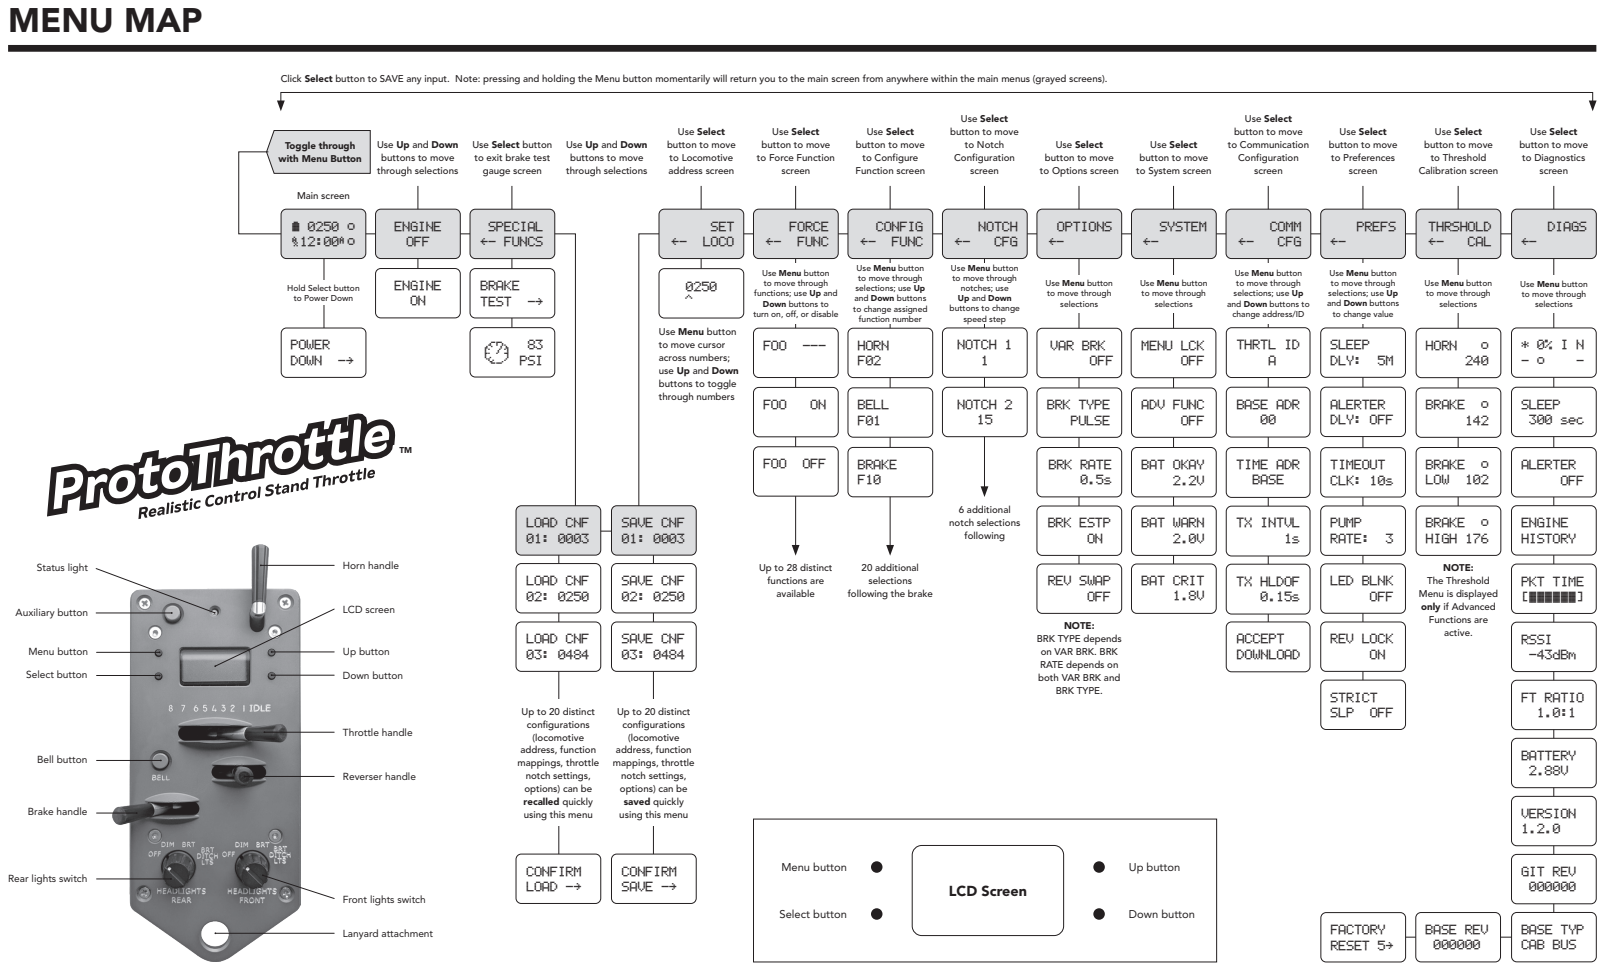
[picture p108: page 1]
ENGINE OFF; ENGINE ON; POWER; DOWN; SPECIAL - FUNCS; BRAKE; TEST; 83 PSI; ÀÁÂÃ ÄÅÆÇ; SET; LOCO; FORCE; FUNC; FOO; OFF; CONFIG; HORN F02; BELL F01; BRAKE F10; NOTCH; CFG; NOTCH 1 1; NOTCH 2 15; LOAD CNF; LOAD; CNF; SAVE CNF 01: 0003; SAVE; CONFIRM LOAD -~; CONFIRM SAVE -~; Main screen; 6 additional notch selections following; OPTIONS -; SYSTEM; VAR; BRK; TYPE; PULSE; RATE; ESTP; REV SWAP OFF; THRSHOLD; CAL; HORN; LOW; HIGH 176; COMM; PREFS; SLEEP; DLY:; sec; PKT; TIME; [ÿÿÿÿÿÿ]; ALERTER OFF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

Use Select
button to move
to Notch
Configuration
screen

to Communication

to Locomotive
address screen

to Force Function

to Configure
Function screen

to Preferences

to Threshold
Calibration screen

to Diagnostics

Toggle through
with Menu Button

Use Up and Down
buttons to move
through selections

Use Select button
to exit brake test
gauge screen

to Options screen

to System screen

Use Menu button
to move through
selections; use Up
and Down buttons
to change assigned
function number

notches; use
Up and Down
buttons to change
speed step

functions; use Up and
Down buttons to
turn on, off, or disable

selections

and Down buttons to
change address/ID

to change value

Hold Select button
to Power Down

to move cursor
across numbers;
use Up and Down
buttons to toggle
through numbers

Up to 28 distinct
functions are
available

20 additional
following the brake

NOTE:
The Threshold
Menu is displayed
only if Advanced
Functions are

active. NOTE:
BRK TYPE depends
on VAR BRK. BRK
RATE depends on
both VAR BRK and
BRK TYPE.

Up to 20 distinct
configurations
(locomotive
address, function
mappings, throttle
notch settings,
options) can be
recalled quickly
using this menu

saved quickly

Rear lights switch

Front lights switch
