IowaScaledEngineering/mrbw-cst/pg/mrbw-cst-v1.1-0f7b72f/mrbw-cst-pcb.pdf

# mrbw-cst.pcb

# 1. Table of Contents (This Page) Created on Wed Feb 8 18:57:55 2017

# 2. top 3. bottom 4. outline 5. plated-drill 6. componentmask 7. soldermask 8. topsilk 9. bottomsilk 10. toppaste 11. topassembly 12. bottomassembly 13. fab

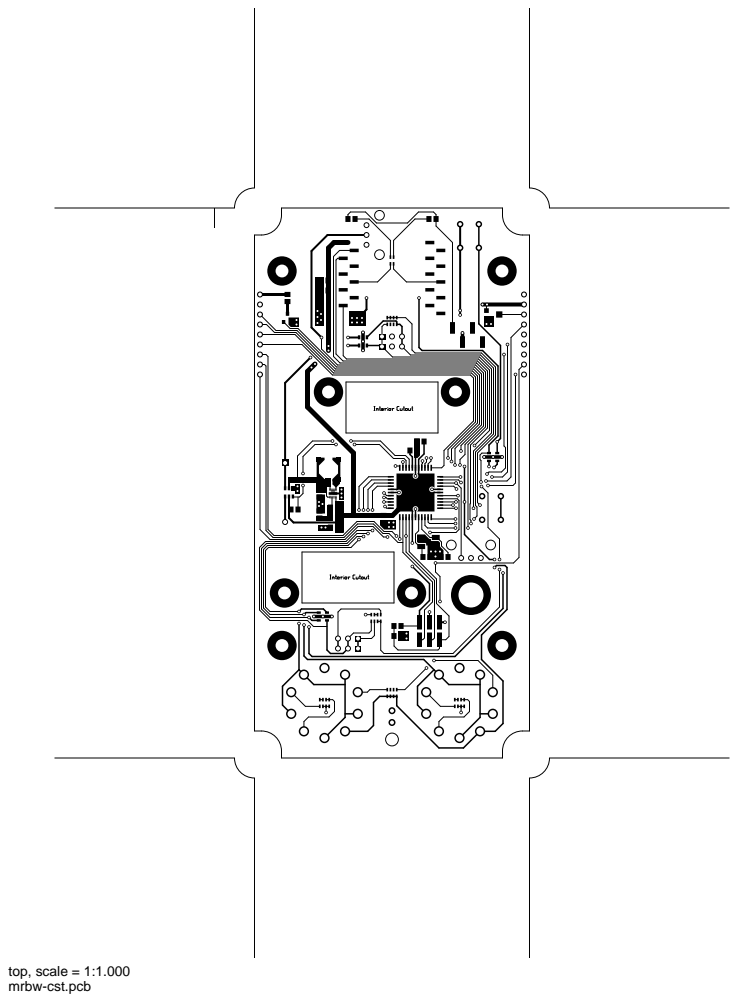
[picture p109: page 2]
top, scale = 1:1.000

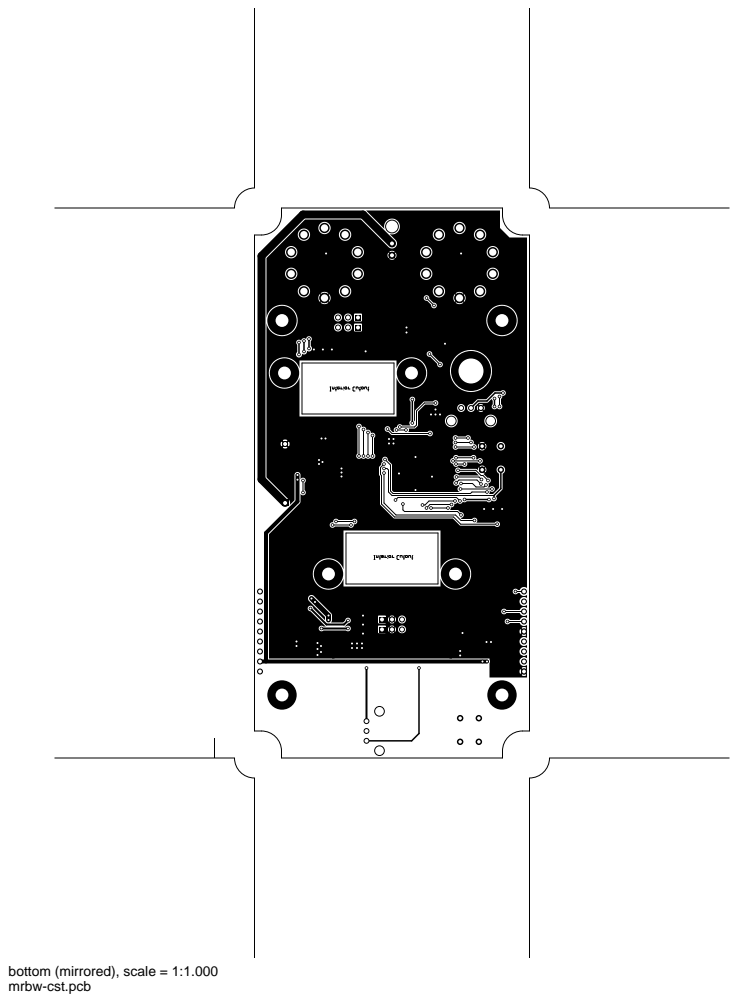
[picture p110: page 3]

bottom (mirrored), scale = 1:1.000

outline, scale = 1:1.000

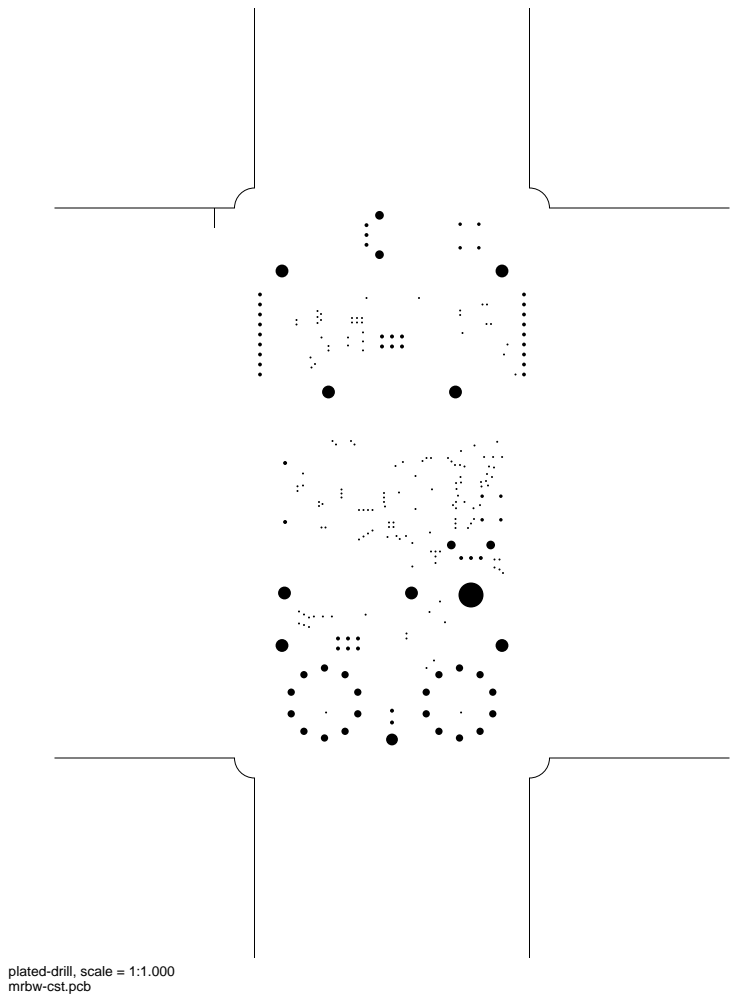
[picture p111: page 5]

plated-drill, scale = 1:1.000

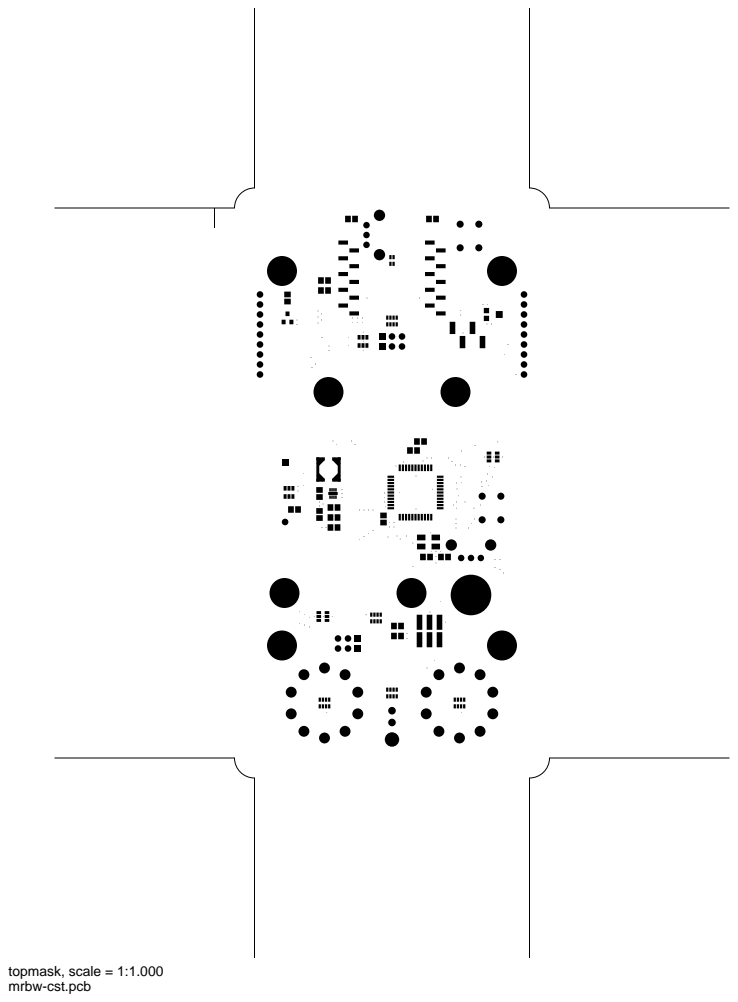
[picture p112: page 6]
topmask, scale = 1:1.000

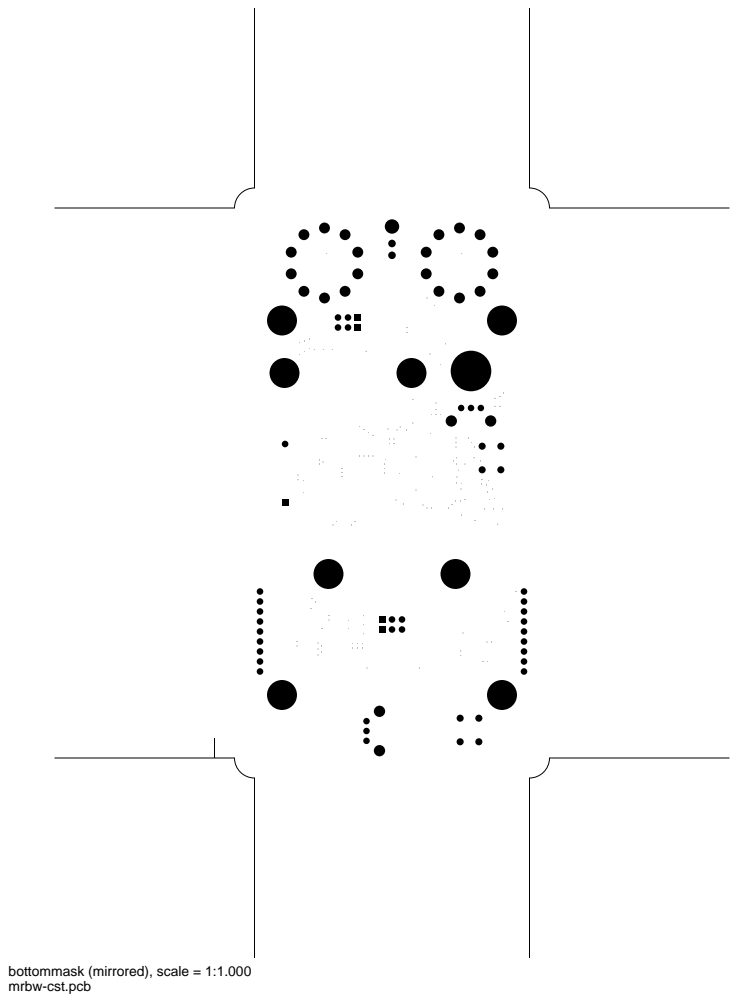
[picture p113: page 7]

bottommask (mirrored), scale = 1:1.000

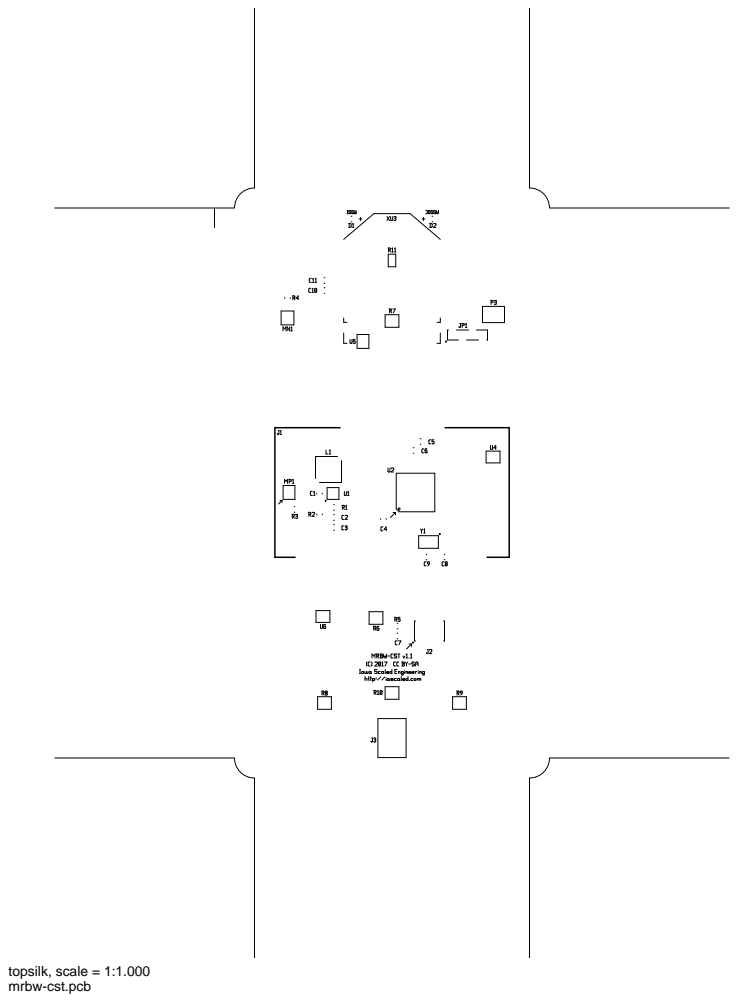
[picture p114: page 8]
topsilk, scale = 1:1.000

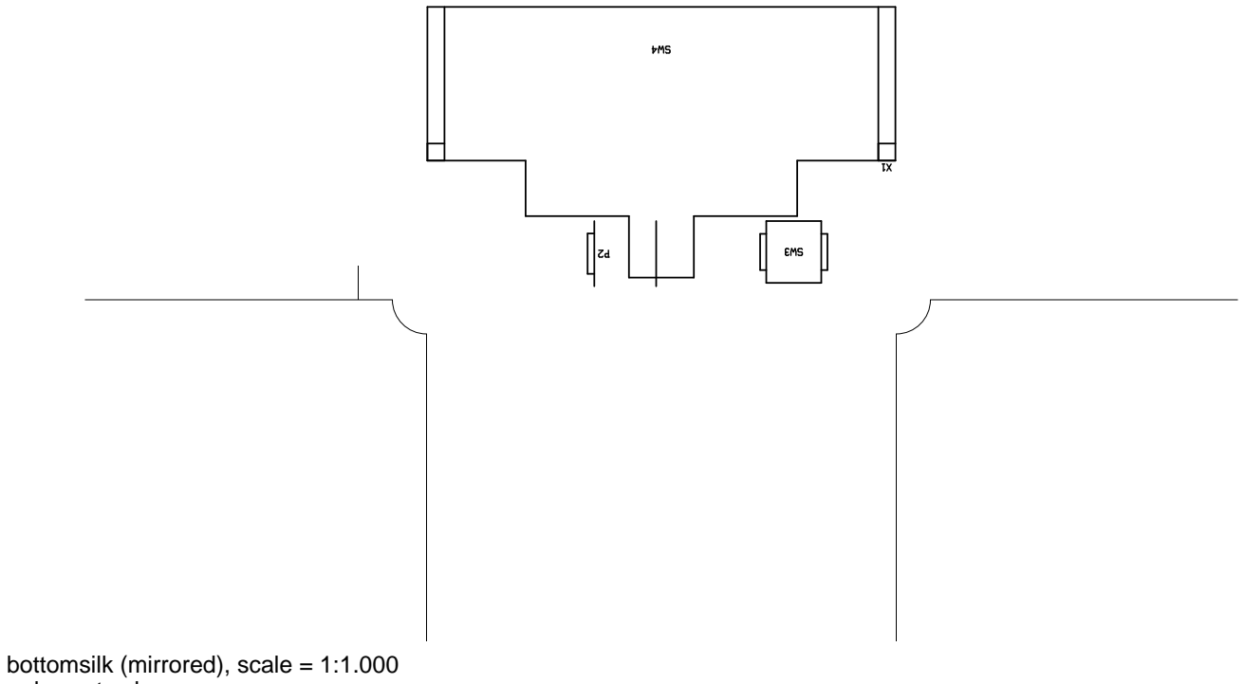
[picture p115: figure]
bottomsilk (mirrored), scale = 1:1.000

toppaste, scale = 1:1.000

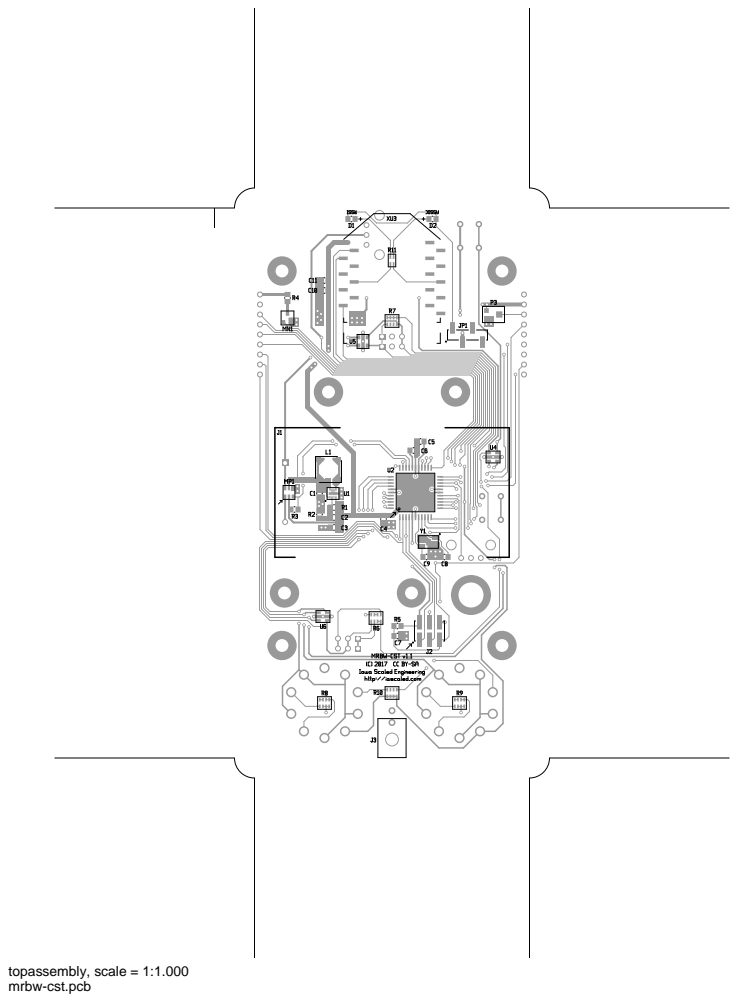
[picture p116: page 11]
topassembly, scale = 1:1.000

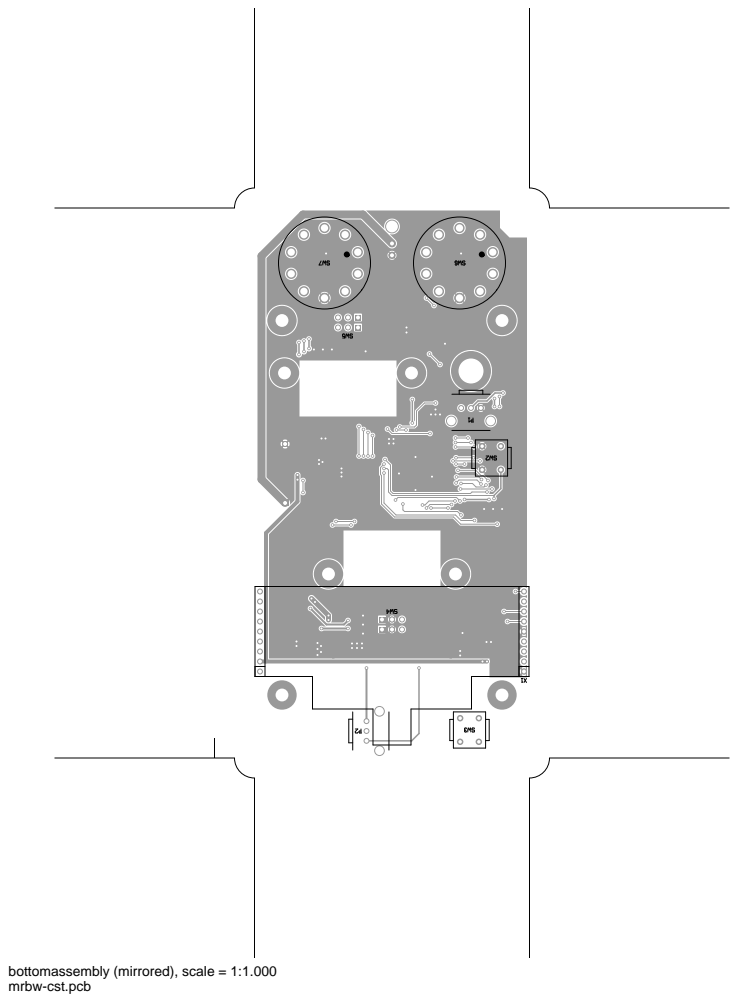
[picture p117: page 12]

bottomassembly (mirrored), scale = 1:1.000

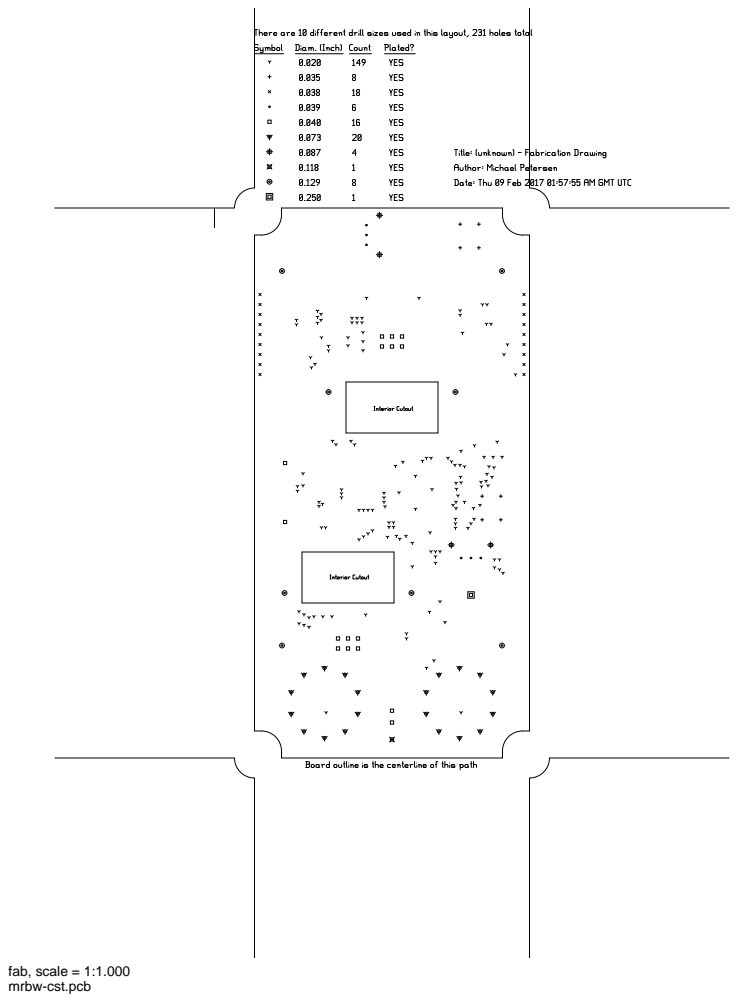
[picture p118: page 13]
fab, scale = 1:1.000
