IowaScaledEngineering/mrbw-cst/pg/mrbw-cst-v1.0-6746dc4/mrbw-cst-pcb.pdf

# mrbw-cst.pcb

# 1. Table of Contents (This Page) Created on Mon Jun 27 21:12:40 2016

# 2. top 3. bottom 4. outline 5. plated-drill 6. componentmask 7. soldermask 8. topsilk 9. bottomsilk 10. toppaste 11. topassembly 12. bottomassembly 13. fab

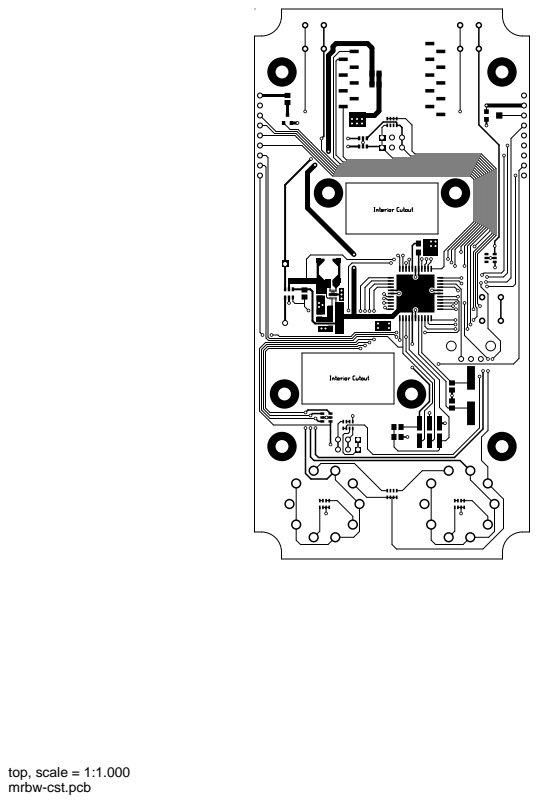
[picture p119: page 2]
top, scale = 1:1.000

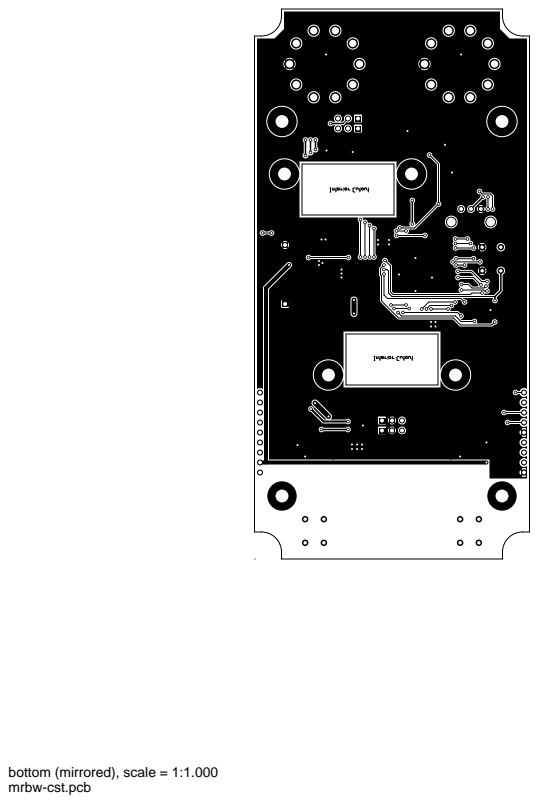
[picture p120: page 3]

bottom (mirrored), scale = 1:1.000

outline, scale = 1:1.000

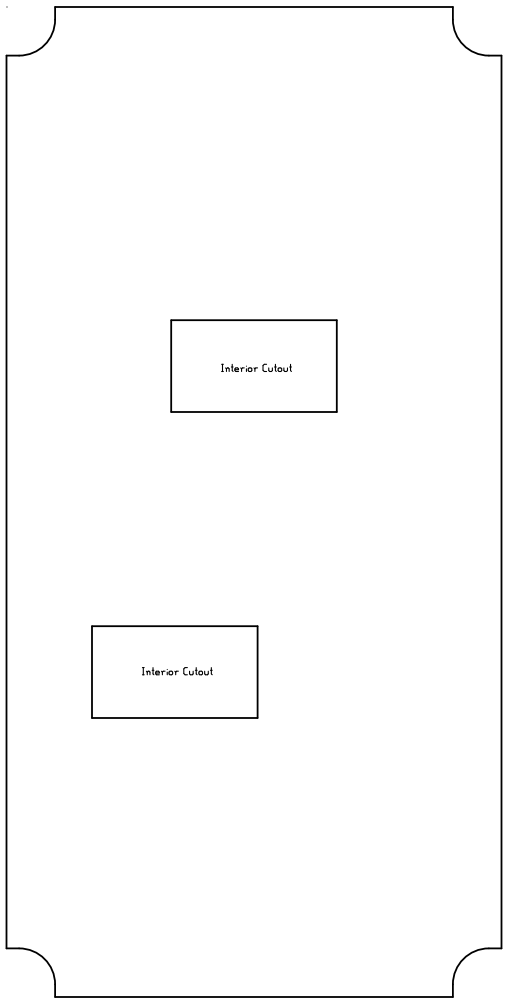
[picture p121: figure]
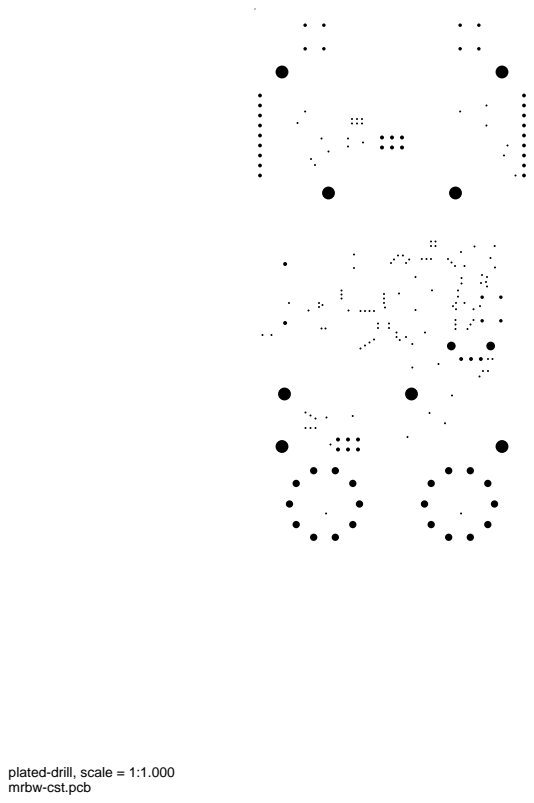
[picture p122: page 5]

plated-drill, scale = 1:1.000

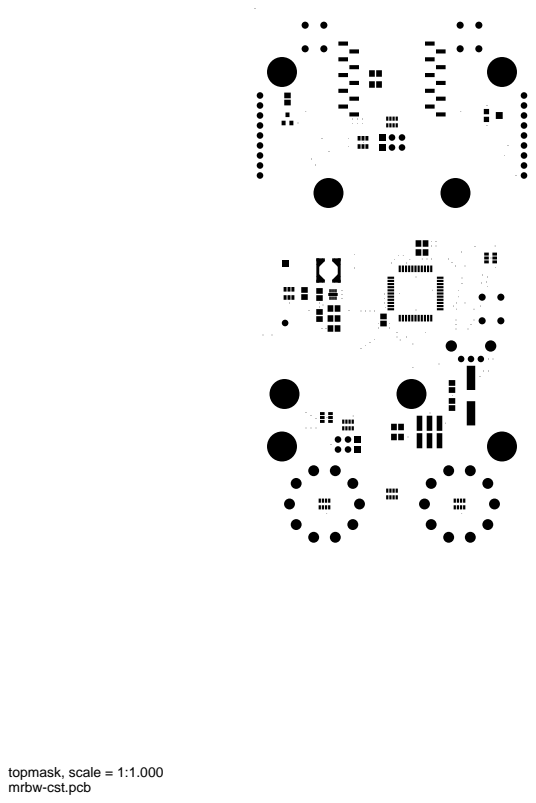
[picture p123: page 6]
topmask, scale = 1:1.000

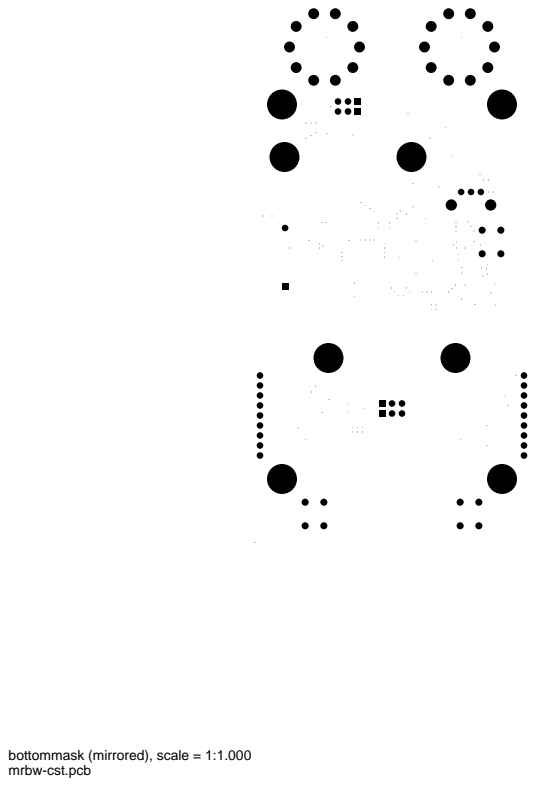
[picture p124: page 7]

bottommask (mirrored), scale = 1:1.000

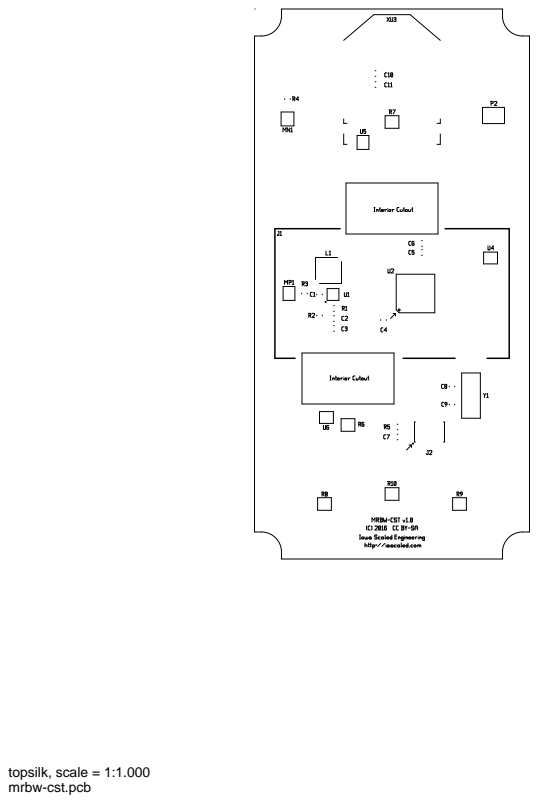
[picture p125: page 8]
topsilk, scale = 1:1.000

bottomsilk (mirrored), scale = 1:1.000

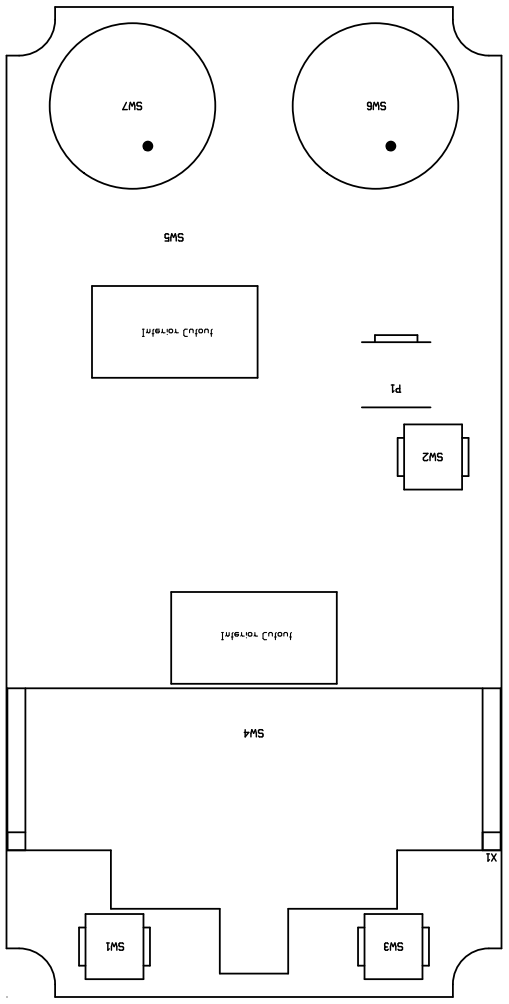
[picture p126: figure]

toppaste, scale = 1:1.000

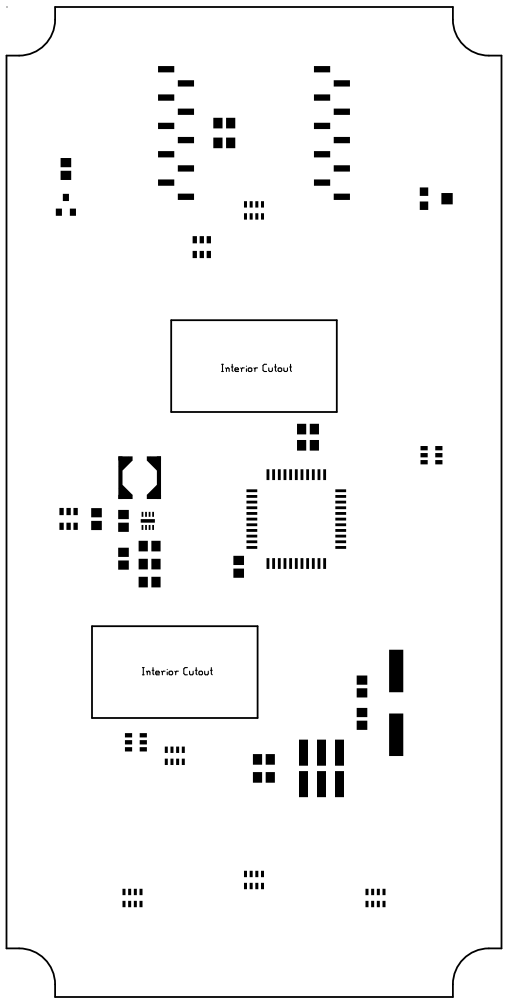
[picture p127: figure]
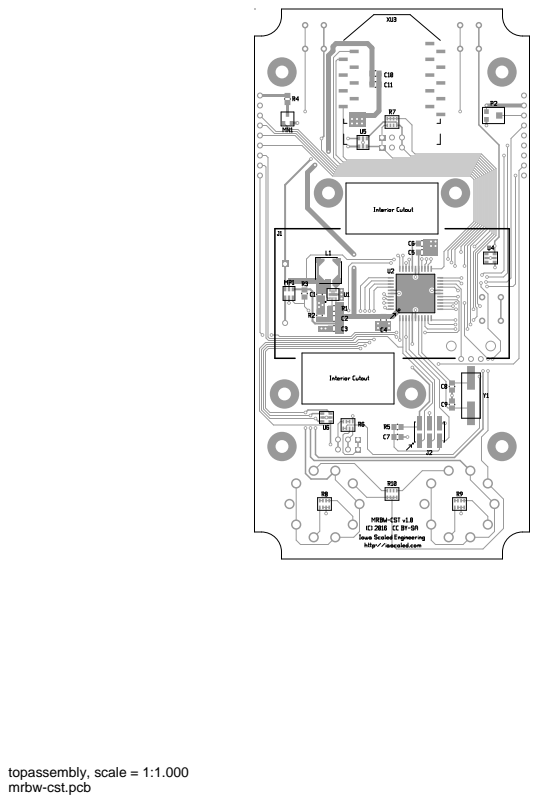
[picture p128: page 11]
topassembly, scale = 1:1.000

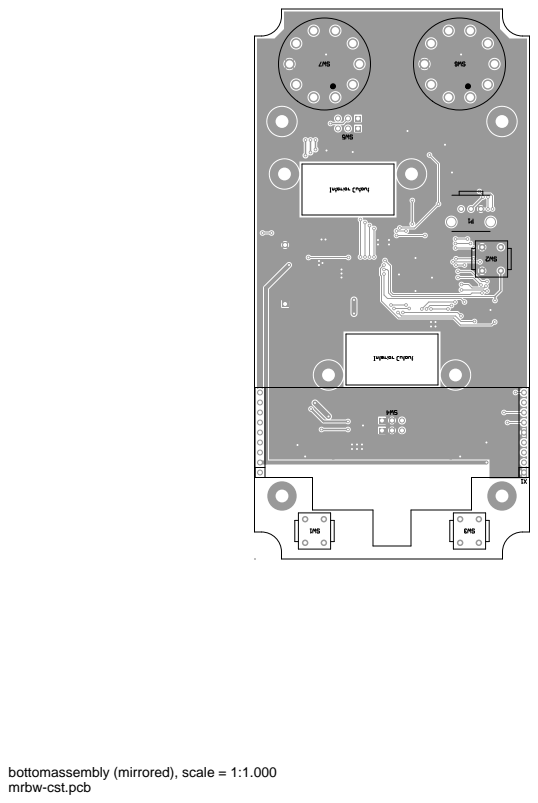
[picture p129: page 12]

bottomassembly (mirrored), scale = 1:1.000

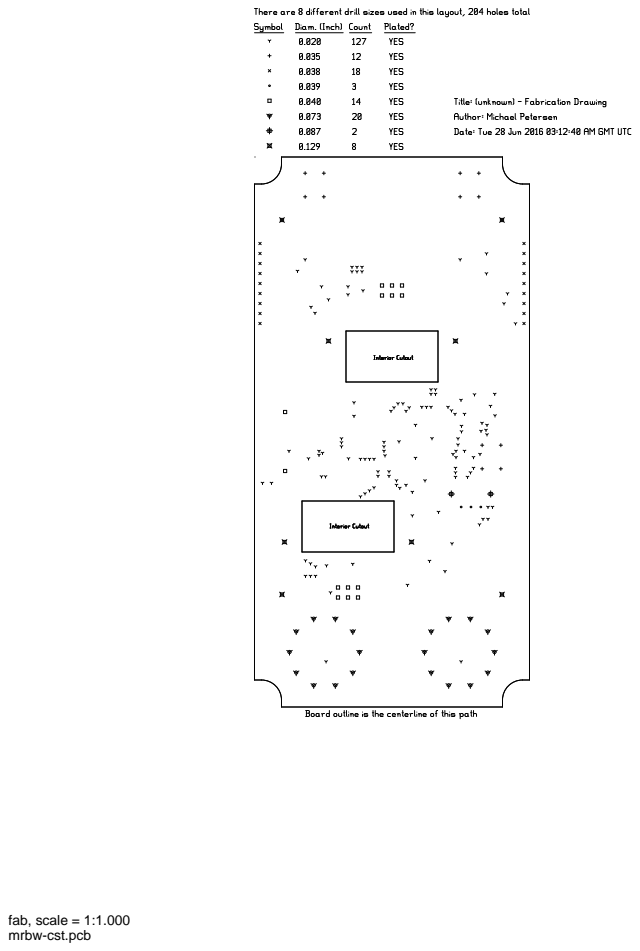
[picture p130: page 13]
fab, scale = 1:1.000
