IowaScaledEngineering/mrbw-cst/(list of files, drawings)

Other design files:
pcb/lcd-test.pcb
pcb/mrbw-cst-lcd.pcb
pcb/mrbw-cst.pcb
