IowaScaledEngineering/mrbw-cst/src/cst-math.h

#ifndef _CST_MATH_H_
#define _CST_MATH_H_

#include <math.h>

#define max(a,b)  ((a)>(b)?(a):(b))
#define min(a,b)  ((a)<(b)?(a):(b))

#define PI           3.1415926535897932384626433
#define TWOPI        (2.0 * PI)
#define TWO_OVER_PI  (2.0 / PI)
#define HALFPI       (PI / 2.0)

float cos_32s(float x);
float cos_32(float x);
float sin_32(float x);

#endif
