IowaScaledEngineering/mrbw-cst/(commit log)

2016-05-28 Initial checkin
    [100SP2T1B1M1QEH.dwg, 25LB10-Q(side).dwg, 25LB10-Q.dwg, PTV09A-2020F-B104.dwg, PVA1-EE-H2.dwg, PVA1-OA-H2.dwg, PVA1-OA-H3.dwg, PVA1-OA-H4.dwg]
2016-05-29 Wired pushbuttons. Still short 1 pin for 5V enable...
    [mrbw-cst.sch]
2016-05-29 Changed to ATmega164. Added LCD and softkeys.
    [mrbw-cst.sch]
2016-05-29 Moved pin assignments on AVR to make LCD control lines more logical.
    [mrbw-cst.sch]
2016-05-29 Changed rotary encode footprints to TBD since these will be special connectors, not direct component footprints
    [mrbw-cst.sch]
2016-06-02 Changed to LCD/switches on separate board (mrbw-cst-lcd)
    [2-1825910-(6-9).dwg, 3-1825910-(1-3).dwg, NHD-0208AZ-FSW-GBW-33V3.dwg, mrbw-cst-lcd.pcb, mrbw-cst-lcd.sch, mrbw-cst.sch, side.dwg]
2016-06-02 Custom footprint
2016-06-02 Renamed footprint
2016-06-07 Repository re-org/cleanup
    [100SP2T1B1M1QEH.dwg, 2-1825910-(6-9).dwg, 25LB10-Q(side).dwg, 25LB10-Q.dwg, 3-1825910-(1-3).dwg, NHD-0208AZ-FSW-GBW-33V3.dwg, PPTC032LJBN-RC.dwg, PTV09A-2020F-B104.dwg]
2016-06-07 Schematic cleanup
    [mrbw-cst.sch]
2016-06-08 Moved LED and some ESD diodes to LCD board
    [mrbw-cst-lcd.pcb, mrbw-cst-lcd.sch, mrbw-cst.sch]
2016-06-09 Added light pipe
    [side.dwg]
2016-06-09 Removed softkey ESD diodes (now on LCD board) Refdes and r-pack cleanup and consolidation
    [mrbw-cst.sch]
2016-06-09 Trace cleanup to allow possible notching for switches on main board
    [mrbw-cst-lcd.pcb]
2016-06-09 Added battery footprint
    [mrbw-cst.sch]
2016-06-11 Created footprint for rotary encoders
    [25LB10-Q.dwg, PPTC032LJBN-RC.dwg, front.dwg]
2016-06-13 More mechanical engineering...
    [25LB10-Q.dwg, PTV09A-2020F-B104.dwg, Rxxx07RN02Q.dwg, front.dwg, mrbw-cst-lcd.dwg, mrbw-cst-lcd.pcb, side.dwg]
2016-06-15 More mechanicals
    [CU-1943.dwg, Hammond-1591D.dwg, PPTC032LJBN-RC.dwg, front.dwg]
2016-06-16 More 1591D updates
    [front.dwg]
2016-06-16 Adjusted headlight switches
    [front.dwg]
2016-06-16 Updated drawing to match Scott's sketch
    [PTV09A-2020F-B104.dwg, PVA1.dwg, front.dwg, mrbw-cst-lcd.dwg, mrbw-cst-lcd.pcb]
2016-06-16 Turned on text
    [side.dwg]
2016-06-18 Started main PCB
    [PVA1.dwg, front.dwg, mrbw-cst.pcb]
2016-06-18 Imported all components
    [mrbw-cst.pcb, mrbw-cst.sch]
2016-06-22 Placing components
    [front.dwg, mrbw-cst.pcb, mrbw-cst.sch]
2016-06-22 Placed all user controls
    [front.dwg, mrbw-cst.pcb]
2016-06-22 Some layout completed
    [mrbw-cst.pcb]
2016-06-23 Added knob to drawing
    [6094K850_INDICATING_KNOB.DWG, mrbw-cst.pcb, side.dwg]
2016-06-23 More layout... progress?
    [mrbw-cst.pcb, mrbw-cst.sch]
2016-06-23 Rotated switches
    [mrbw-cst.pcb]
2016-06-23 More layout
    [mrbw-cst.pcb]
2016-06-24 PCB complete
    [mrbw-cst.pcb, mrbw-cst.sch]
2016-06-25 Added bracket holes for encoders. Updated mechanical drawing.
    [front.dwg, mrbw-cst.dwg, mrbw-cst.pcb, mrbw-cst.sch]
2016-06-26 Fixes after review
    [mrbw-cst.pcb]
2016-06-26 Removed GND planes to try and meet keepout areas for xbee
    [mrbw-cst-lcd.pcb, mrbw-cst.pcb]
2016-06-26 Reconnected GND to the LED
    [mrbw-cst-lcd.pcb]
2016-06-28 Fixed odd angle lines DRC/LVS clean
    [mrbw-cst-lcd.pcb]
2016-06-28 Minor tweaks to improve GND plane coverage DRC/LVS clean
    [mrbw-cst.pcb]
2016-06-28 Sent to fab 6/27/2016
    [mrbw-cst-lcd.bottom.gbr, mrbw-cst-lcd.bottommask.gbr, mrbw-cst-lcd.bottompaste.gbr, mrbw-cst-lcd.bottomsilk.gbr, mrbw-cst-lcd.fab.gbr, mrbw-cst-lcd.outline.gbr, mrbw-cst-lcd.top.gbr, mrbw-cst-lcd.topmask.gbr]
2016-07-26 Changed throttle code to display I (for idle) and 1-8. Reversed direction of throttle.
    [mrbw-cst.c]
2016-07-26 Files for encoder bracket
    [encoder-bracket.dwg, encoder-bracket.f3d, encoder-bracket.stl]
2016-08-13 Added filtering to headlight switches
2016-09-13 CKT-CST design to test USB + battery charging
    [ckt-cst.sch]
2016-09-14 Minor tweaks
    [ckt-cst.sch]
2016-09-14 Fixed issue #1 "Missing pin 1 mark on MP1"
    [mrbw-cst.pcb]
2016-09-14 Fixed Issue #2 "R6 and U6 collide with the header for SW5"
    [mrbw-cst.pcb, mrbw-cst.sch]
2016-09-14 Main schematic changes to accommodate charger and USB.
    [mrbw-cst.sch]
2016-09-14 Prep for USB + charger
    [mrbw-cst.pcb, mrbw-cst.sch]
2016-09-14 USB + Charger schematic
    [ckt-cst.sch, mrbw-cst-usb.sch]
2016-09-29 Revert "USB + Charger schematic"
    This reverts commit 02a82304549cd846fd454c78343b32d99d60a26a.
    [ckt-cst.sch, mrbw-cst-usb.sch]
2016-09-29 Revert "Prep for USB + charger"
    This reverts commit 0d9a486d05533a0c0eff8cb007894572fc6277b5.
    [mrbw-cst.pcb, mrbw-cst.sch]
2016-09-29 Revert "Main schematic changes to accommodate charger and USB."
    This reverts commit 5b5fd40b012058d50efa9056b2c90693fcd00b77.
    [mrbw-cst.sch]
2016-09-29 Packet format
    [packet.ods]
2016-09-29 Incorporated Nathan's feedback
    [packet.ods]
2016-10-09 More cleanup. Connecting controls to MRBee packet bytes.
    [packet.ods]
2016-10-09 Improved light switch deglitching
2016-10-09 Change LED blink rate to 2sec. Added menu infrastructure.
2016-10-10 Menu implementation, but button press code not very good.
2016-10-10 Fixed up menus and button autoincrement.
    [mrbw-cst.c]
2016-10-10 Added send-on-change to the packet handler. Other minor cleanup. *Warning* Has a bug: the LCD routines can corrupt PORTC, where the reverser and other enables reside, during a read-modify-write since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
    [cst-hardware.c, cst-hardware.h, mrbw-cst.c]
2016-10-11 Rrfactored ADC code. Moved most of it out of the ISR to avoid atomic issues. Swapped light switches in code (addresses Issue #8) Other minor changes
    [cst-hardware.c, cst-hardware.h, mrbw-cst.c]
2016-10-11 Added bell and horn to packet. Improved function handling.
    [packet.ods]
2016-10-12 Turned LED back on.
2016-10-12 Really turn LED on this time...
2017-01-15 Swapped front/rear light switch connections. Fixes Issue #8
    [mrbw-cst.pcb, mrbw-cst.sch]
2017-01-16 Rotates light switches counter-clockwise 90 degrees. Fixes #5
    [mrbw-cst.pcb]
2017-01-16 Added RSSI/ASSOC LEDs and jumper to schematic. Issue #9
    [mrbw-cst.sch]
2017-01-16 Removed extra components outside schematic frame.
    [mrbw-cst.sch]
2017-01-16 Cleanup (OCD)
    [mrbw-cst.sch]
2017-01-16 Added RSSI/ASSOC LEDs. Fixes #9
    [mrbw-cst.pcb]
2017-01-17 Changes xtal to 4-SMD version.
    [mrbw-cst.sch]
2017-01-17 Changed to 4-SMD xtal. Fixes #14
    [mrbw-cst.pcb]
2017-01-17 Added hole for friction device on brake potentiometer. Fixes #10
    [mrbw-cst.pcb, mrbw-cst.sch]
2017-01-18 Changed horn to potentiometer. Fixes #13
    [mrbw-cst.pcb, mrbw-cst.sch]
2017-01-30 Added charging connector
    [mrbw-cst.pcb, mrbw-cst.sch]
2017-01-30 Changed brake screw hole to 250mil
    [mrbw-cst.pcb, mrbw-cst.sch]
2017-02-02 Added ESD diodes to POTS_EN and LIGHT_EN.
    [mrbw-cst.pcb, mrbw-cst.sch]
2017-02-02 Swapped MP1 on LCD power line (source to input 3.3V)
    [mrbw-cst.pcb, mrbw-cst.sch]
2017-02-02 Removed jumper on XBee power line
    [mrbw-cst.pcb]
2017-02-02 Improved XBee routing to bypass caps (moved caps)
    [mrbw-cst.pcb]
2017-02-03 Improved ESD diode GND connections. Shortened bottom jumper on MP1 gate. Improved GND plane where possible.
    [mrbw-cst.pcb]
2017-02-03 Remove/Minimize jumpers in GND plane.
    [mrbw-cst.pcb]
2017-02-07 Added extra via(s) for P3, MN1, SW3 GND/PWR connections. Removed dummy Ux ESD diode pack.
    [mrbw-cst.pcb]
2017-02-09 Cleanup edits from review
    [mrbw-cst.pcb]
2017-02-09 Sent to fab 2/8/2017
    [mrbw-cst.bottom.gbr, mrbw-cst.bottommask.gbr, mrbw-cst.bottompaste.gbr, mrbw-cst.bottomsilk.gbr, mrbw-cst.fab.gbr, mrbw-cst.outline.gbr, mrbw-cst.top.gbr, mrbw-cst.topmask.gbr]
2017-02-20 Changed SW2 to latching type pushbutton. Swapped bell and dynamic pushbuttons (zero net change, just labeling).
    [mrbw-cst.sch]
2017-02-20 Enlarged shaft hole, locate pin hole, and removed captive nut cutouts.
    [encoder-bracket.f3d, encoder-bracket.stl]
2017-03-06 Cleaned up menu text (made arrow point to button for sub-menu). Added EEPROM storage for MRBus address.
2017-03-06 Set "preserve EEPROM" fuse
2017-03-07 Changed buttons from bit masks to pin names
2017-03-07 Added sleep config screen, cleaned up sleep timer value code.
2017-03-09 Move LCD init into a separate function. Save button state when exiting sleep to prevent false button press. Commented out sleep debug screen.
    [mrbw-cst.c]
2017-03-16 Changed to interrupt driven quadrature decoder
2017-03-16 Added option buttons to MRBee packet trigger
2017-03-17 Fixed fuction mapping (_BV doesn't work on 32-bit numbers) Fixed ADC settling at turn on.
    [cst-hardware.c, cst-hardware.h, mrbw-cst.c]
2017-03-19 Made sleep reset on any input change.
    [mrbw-cst.c]
2017-03-19 Fixed throttle glitch on power-up/resume from sleep due to detecting false edge
    [cst-hardware.c, cst-hardware.h, mrbw-cst.c]
2017-03-19 Fixed case where LED could be left on in sleep
    [mrbw-cst.c]
2017-03-20 Added pkt timeout and battery voltage indicator.
2017-03-22 Changed function key char name. Reset pkt timeout correctly on startup.
    [cst-lcd.h, mrbw-cst.c]
2017-03-23 Prevented from executing sleep code when reverser in forward or reverse. Sprinkled some wdt_reset() calls.
    [mrbw-cst.c]
2017-03-24 Untied the knot I tied with LCD chars. Seems to be fixed now.
    [cst-lcd.h, mrbw-cst.c]
2017-03-30 Interlocked throttle and reverser settings
    [mrbw-cst.c]
2017-03-31 v0.6. Refined throttle and reverser interlocks.
    [mrbw-cst.c]
2017-04-25 Rearranged brake and throttle on diag screen.
2017-04-25 Enter sleep based on actual reverser setting, not just the lever position. (Must really be in neutral)
    [mrbw-cst.c]
2017-04-25 Refactored sleep code to use pin change wakeup
2017-04-26 Added skeletons for threshold and throttle configs
2017-04-27 Increased screw hole size (closes #18) Made registration hole deeper (closes #19)
    [encoder-bracket.f3d, encoder-bracket.stl]
2017-04-28 v0.62 Added horn, brake, brake low, and emergency thresholds
2017-04-28 Converted brake threshold detection over to a control bit
2017-04-28 Added brake (DCC) function. v0.63
2017-05-01 Change default packet timeout to 5sec. Only reset packet timeout if packet is from programmed base station. Change default base address to 0xE0. Disallow 0xFF for base address and 0x00 for all addres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
    [mrbw-cst.c]
2017-05-01 Moved sleep timer min/default/max to defines
2017-05-20 Changed SET FUNC to FORCE FUNC. Added preference setting so Scott could turn off the blinky LED. Increased brake dead zone and calculated span by including dead zone.
2017-05-24 Added factory reset. Changed LOCO screen to not exit back to home screen.
    [mrbw-cst.c]
2017-05-24 Merged statusFlags into throttleStatus
2017-06-23 Fixed brake decode logic
    [mrbw-cst.c]
2017-07-01 Changed light selection switches to KC14 style. Closes #17. Added test point on PB3. Closes #15.
    [mrbw-cst.sch]
2017-07-01 Changed C12/13 caps to DNI
    [mrbw-cst.sch]
2017-07-03 Labeled light switches and marked center locations
    [mrbw-cst.pcb]
2017-07-03 Added new light switches. Reduced charger line width around switches.
    [mrbw-cst.pcb]
2017-07-03 Wired test point. Started wiring new light switches.
    [mrbw-cst.pcb]
2017-07-23 Inserted new switch footprint (mirrored). Wired light switches.
    [mrbw-cst.pcb]
2017-07-23 Moved P2 50mils right. Closes #16.
    [mrbw-cst.pcb]
2017-07-23 Cleaned up XU3 silk
    [mrbw-cst.pcb]
2017-07-23 Added hole for horn spring. Closes #20.
    [mrbw-cst.pcb]
2017-08-22 Rotated R10 text
    [mrbw-cst.pcb]
2017-09-12 Latest rev
    [mrbw-cst.bottom.gbr, mrbw-cst.bottommask.gbr, mrbw-cst.bottompaste.gbr, mrbw-cst.bottomsilk.gbr, mrbw-cst.fab.gbr, mrbw-cst.outline.gbr, mrbw-cst.top.gbr, mrbw-cst.topmask.gbr]
2017-09-12 Datasheets for LCD board connectors
2017-09-21 Changed RCL CONF to LOAD CFG. Added detection of reverser position not equal to active reverser setting and alert user. Changed actual...Setting to active...Setting
    [mrbw-cst.c]
2017-09-22 Changed DYNAMIC to AUX. Alert user when active reverser != reverser control.
    [cst-hardware.h, mrbw-cst.c]
2017-09-22 Changed emergency threshold to brake high. Applied deadzone to brake high. Added option to enable/disable estop on the brake lever.
2017-09-25 First attempt to add short address support. Doesn't work yet, though.
    [mrbw-cst.c]
2017-09-25 Added short address support.
    [mrbw-cst.c]
2017-09-30 Reset subscreenStatus to zero after factory reset. Fixes #29
    [mrbw-cst.c]
2017-09-30 Fixes #29 in a better way (WDT reset)
    [mrbw-cst.c]
2017-09-30 Reset pktTimeout to zero. Assume no base until one has been heard from. Fixes #28
    [mrbw-cst.c]
2017-10-05 Support for hardwre rev v1.2 (new light switches)
2017-10-07 Fixed PINB mask (removed SLEEP_EN from debounce)
    [mrbw-cst.c]
2017-10-07 Changed defaults for AUX, UP and DOWN buttons
2017-10-15 Removed disable functions from ADC loop. IDD before change: 2.39V = 91.8mA IDD after change: 2.39V = 92.0mA No significant change leaving the controls enabled (as expected).
2017-10-17 Interlocked engine stop with throttle being in idle
2017-10-22 Added hystersis to horn and brake controls.
2017-10-23 Initial attempt at caching LCD driver.
2017-10-24 Fixed tonnage display coming out of sleep. Refactored tonnage code into separate files. Updated source code headers.
    [cst-hardware.c, cst-lcd.c, cst-lcd.h, cst-tonnage.c, lcd.c, mrbw-cst.c]
2017-10-25 Moved battery stuff into cst-hardware
2017-10-25 Moved battery code into cst-battery.*
2017-12-12 Updated symbol and part # for uC
    [mrbw-cst.sch]
2018-01-07 Updated MRBus library to report RSSI on a per-packet basis. Fixes #35
    [mrbw-cst.c]
2018-01-07 Applied txHoldoff to all transmissions, not just control changes. Fixes #34
    [mrbw-cst.c]
2018-01-07 Bounded device address and base address with min/max
2018-01-07 Changed device address to a single letter. Changed base address to a number from 0 to 31. Fixes #36
    [mrbw-cst.c]
2018-01-09 Changed PKT TIME screen to a bargraph. Fixes #33
    [mrbw-cst.c]
2018-01-09 Added reverser swap. Fixes #32
    [mrbw-cst.c]
2018-01-11 Added variable brake config bit
2018-01-14 Add variable brake functionality
2018-01-16 Added brake pulse width. Fixes #37
    [mrbw-cst.c]
2018-01-16 Clear THROTTLE_STATUS_EMERGENCY when e-brake not activated. Fixes #39
    [mrbw-cst.c]
2018-01-16 Limited max decisecs to 10. Added limit checks to readConfig and menu code. Fixes #40
    [mrbw-cst.c]
2018-02-10 Pad base type string with spaces instead of null. Changed max() to min() when copying new base type string. Fixes #41
    [mrbw-cst.c]
2018-02-10 Added reverser lock preference option. Fixes #38
    [mrbw-cst.c]
2018-02-10 Added brake off function config
2018-02-10 Implemented brake off function
2018-02-15 Added square bracket characters
2018-02-15 LCD 3D model
    [NHD-0208AZ.STEP]
2018-03-10 Moved transmission timer reset to beginning of if statement. Fixes #42.
    [mrbw-cst.c]
2018-03-28 Properly reset newLocoAddress when entering SET LOCO menu. Fixes #44
    [mrbw-cst.c]
2018-03-28 Reset DIAG LCD characters when waking from sleep. Fixes #43
    [mrbw-cst.c]
2018-04-06 Updated with regulatory info
2018-04-14 Changed engineStopFunction comparison from == to &. Fixes #48.
    [mrbw-cst.c]
2018-04-14 Moved printLocomotiveAdress to cst-lcd
2018-04-14 Increased number of configs to 20. Fixes #47.
    [mrbw-cst.c]
2018-04-14 Changed the method of setting short addresses. Original: Take first digit above 9 New: Take first digit below 0
    [mrbw-cst.c]
2018-04-20 Changed default locomotive address to short 3. Fixes #50.
    [mrbw-cst.c]
2018-04-20 Added confirmation step after load/save. Fixes #51.
    [mrbw-cst.c]
2018-04-20 Added reverser swap function. Changed throttle unlock default to OFF. Fixes #52.
    [mrbw-cst.c]
2018-04-22 Refactored handling of "brake off" function. Also made "brake on" and "brake off" transitions atomic.
2018-04-22 Changed on/off brake to use state machine
2018-04-22 Moved the variable brake into the state machine format.
2018-04-22 Added stepped brake mode
2018-04-22 Remove timer for stepped brake (use minimum tx holdff instead). Updated DIAG screen to show details of stepped brake.
2018-05-09 XY file for assembly
2018-05-12 Reset time dead reckoning when coming out of sleep Fixes #56
    [cst-time.c, cst-time.h, mrbw-cst.c]
2018-06-08 Changed PWM braking to PULSE braking. Changed BRK PWM to BRK RATE. Refactored menu code in options and prefs submenus to better handle wraparound state.
2018-06-23 Cleaned up battery code
2018-09-22 Moved function display into first DIAGS screen. Fixes #72
    [mrbw-cst.c]
2018-09-22 Changed adcLoopInitialized condition from 32 to 64 to match averaging in ISR Fixed battery behavior at startup (step function to initial value, then filter it) Renamed buttonsEnable to enableButtons 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
    [cst-battery.c, cst-hardware.c, cst-hardware.h, mrbw-cst.c]
2018-09-22 Added critical battery level. Go into low power state (no radio TX). Fixes #63
    [cst-battery.c, cst-battery.h, mrbw-cst.c]
2018-09-22 Turned off LED in battery critical condition.
2018-09-22 Cleaned up battery critical state entry/exit
2018-09-23 Added power off menu. Fixes #71
    [mrbw-cst.c]
2018-10-01 Added AUX button indicator
2018-10-03 Added System Menu and Advanced Functions + Menu Lock. Moved power down into Advanced Functions
2018-10-03 Conditionally hide brake configuration options if they don't apply. Fixes #68
    [mrbw-cst.c]
2018-10-09 Added version ID to EEPROM. Fixes #58
    [mrbw-cst.c]
2018-10-10 Changed condition for down button in LOAD/SAVE menus Fixed typo in comment
    [mrbw-cst.c]
2018-10-11 Fixed battery state comparison
    [cst-battery.c]
2018-10-11 Add hysteresis to battery state changes
2018-10-11 Added battery levels to resetConfig
    [mrbw-cst.c]
2018-10-18 Moved power down to long-press SELECT button on main screen
2018-10-27 Fixed decrement from latching to momentary
    [cst-functions.c]
2018-10-27 Reset position when escaping CONFIG FUNC menu
    [cst-functions.c, cst-functions.h, mrbw-cst.c]
2018-10-27 Removed EE_CURRENT_CONFIG (no longer needed since always using working config) Changed config offset from function to define, always point config addresses to working config Changed copyConfig to a b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
    [cst-eeprom.h, cst-functions.c, mrbw-cst.c]
2018-12-18 Added pocket for capture nut. Chamfered bolt holes.
    [encoder-bracket.f3d, encoder-bracket.stl]
2019-02-12 Reworked LCD character code, added setupLCD function
    [cst-common.h, cst-lcd.c, cst-lcd.h, mrbw-cst.c]
2019-02-12 Change to prevent a button press on one menu from spilling over to the next. Fixes #79
    [mrbw-cst.c]
2019-02-12 Added pressure char call
2019-02-12 Added pressure chars
2019-02-12 Pressure skeleton code
2019-02-12 Moved pressure drawing to cst-pressure
2019-02-13 Renamed pressure chars, draws all chars on screen
2019-02-17 Functional pressure gauge and pumping based on notch 3
2019-02-28 Clamped low end at 0 PSI during brake test.
2019-03-24 New style encoder bracket, redrawn, with thicker base under nut
    [encoder-bracket.f3d, encoder-bracket.stl]
2019-04-09 GCode for i3 MK3 printer
2019-04-13 ProtoThrottle Pocket design files
    [pt-pocket.stl]
2019-05-19 Encoder bracket v8 (better nut pocket)
    [encoder-bracket.f3d, encoder-bracket.stl]
2019-06-07 Tied new function code into mrbw-cst.c Added E-stop as function option. Fixes #70
    [cst-functions.c, cst-functions.h, mrbw-cst.c]
2019-06-08 Added air pressure related functions and cleaned up other function processing code
2019-12-07 Added power level checking
2019-12-07 Added reflected pocket layout on bed
2019-12-07 Turned on fan before bridge
2020-03-28 Additional (or improved) mechanical bits
    [window.dxf]
2020-03-28 Moved TX Interval and Holdoff to COMM menu. Fixes #74
    [mrbw-cst.c]
2020-03-28 Extended fast clock timeout with options of 30, 60, 90, and 120s. Refactored maxDeadReckoning code. Fixes #75 Fixes #84
    [cst-time.c, cst-time.h, mrbw-cst.c]
2020-03-29 Renamed ENGINE menu to PR.MOVER. Reduced prime mover starting/stopping delay from 5s to 2s. Allowed prime mover to be started again when on. Fixes #66.
    [mrbw-cst.c]
2020-03-29 Added function when reverser is centered. Fixes #76
    [cst-eeprom.h, cst-functions.c, cst-functions.h, mrbw-cst.c]
2020-03-29 Added strict sleep preference bit to enable (or disable) reverser position checking when going to sleep. Fixes #85
    [mrbw-cst.c]
2020-03-29 Added quarter pumping rate
2020-03-29 Moved brake test activation to brake handle
2020-03-29 Disable normal brake function when on pressure screen
2020-03-30 Partially reverted 73c5c9e - Changed menu name back to ENGINE
    [mrbw-cst.c]
2020-03-30 Activate throttle unlock function while in pressure screen
2020-03-30 Remove BRK TST text when brake test active
2020-03-30 Removed half and quarter pumping rates. Removed connection between pumping and throttle.
2020-03-30 Randomized starting and ending pressure. Made pump rate proportional to difference between final and current pressure.
2020-03-30 Removed THR_UNLOCK activation during pressure mode. Other cleanup.
2020-03-30 Added brake test screen in front of actual pressure gauge screen
2020-03-30 Changed access key for brake test menu from SELECT to DOWN
2020-03-31 Added programmable pump rate
2020-03-31 Proportional brake test application
2020-03-31 Changed default pump rate
2020-04-01 Added brake test as an assignable button function
2020-04-01 Added menu-specific button function
2020-04-03 Started adding alerter timer code
2020-04-03 Added alerter timer and preference
2020-04-03 Fixed timeout behavior and added indicated on main screen
    [mrbw-cst.c]
2020-04-04 Handle alerter off case
2020-04-04 Reset alerter when changing from off to some value to prevent immediate triggering
    [mrbw-cst.c]
2020-04-04 Reduced pressure pumping times
    [pressure.ods]
2020-04-08 Jump automatically to Factory Reset screen on fresh EEPROM
    [mrbw-cst.c]
2020-04-09 Added compressor stop option bit to stop compressor when pressure at max
2020-04-09 Added some eye candy during the factory reset screen
    [mrbw-cst.c]
2020-04-09 Added 10s timeout to ENGINE screen. Fixes #77.
    [mrbw-cst.c]
2020-04-12 Added ALERTER default function. Changed pumping rate default.
2020-04-14 Refactored pressure code
2020-04-19 Added timer to pulse compressor off when entering brake test mode
2020-05-10 Freeze pressure when entering brake test mode with brake engaged
2020-06-07 Updated encoder bracket with integral threads (v3)
    [encoder-bracket-thread.f3d, encoder-bracket-thread.stl]
2020-07-02 LCD Test Board
    [lcd-test.pcb]
2020-07-04 Sent to fab 7/2
    [lcd-test.bottom.gbr, lcd-test.bottommask.gbr, lcd-test.bottompaste.gbr, lcd-test.bottomsilk.gbr, lcd-test.fab.gbr, lcd-test.outline.gbr, lcd-test.top.gbr, lcd-test.topmask.gbr]
2021-03-07 Made brake position in brake test correspond to a specific pressure reduction from max (not from current pressure). #87 Also refactored brake test code to simplify and remove need for compressor stop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
2021-03-07 Made horn lever momentarily activate function in Force Function menu. Fixes #86
    [mrbw-cst.c]
2021-03-07 Removed limitation on brake pipe pressure reduction
2021-03-08 Fixed typos in documenting comments for 'P' and 'Q' commands
    [mrbw-cst.c]
2021-03-13 doc cleanup
    [packet.ods]
2021-03-15 Fixed wrap-around. Was missing a few cases. #91
    [cst-functions.c]
2021-03-15 Updated fonts with brake test characters
2021-03-15 Fixed alerter function = emergency brake so it would actually activate.
    [mrbw-cst.c]
2021-03-28 Changed R packet to be only extended read Replaced W packet with P packet
    [mrbw-cst.c, test.py]
2021-04-14 Fixed short address selection
    [mrbw-cst.c]
2021-04-14 Add timeout reset any time the throttle gets a read or write packet
    [mrbw-cst.c]
2022-02-06 Added special factory reset compile option
    [mrbw-cst.c]
2024-02-22 3D print files for knob holder
    [knob-holder v8.stl]
